WojciechM98/SynchGaze/README.md

# SynchGaze
A project that allows you to control camera movement by moving your head.

## Project assumptions
The project includes two boards SynchGaze Transmiter and SynchGaze Motor Control that communicate with each other via bluetooth.

## SynchGaze Transmiter
Transmiter board has IMU device to collect position, acceleration and rotation data. Every information is preprocessed and send in real time by ESP32 to Motor Control board.
This board should be neatly attached to the user's head.

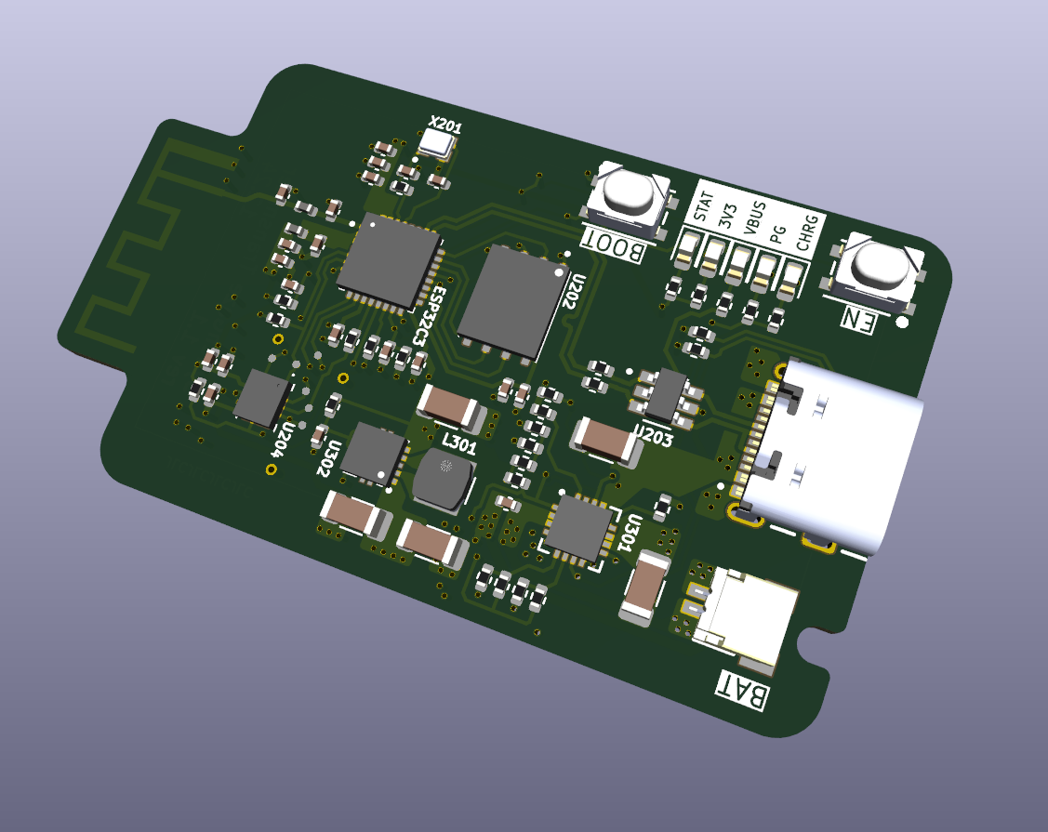
[picture p1: SynchGaze_Transmiter/SynchGaze_Transmiter_v1.1.png]
SynchGaze Transmiter board.


## SynchGaze Motor Control
Motor Control board recieve preprocessed data from Transmiter and converts it into BLDC motors movement. STM32 works in closed loop gathering data from external IMU device whith is attached in the same place as camera. When new information from Transmiter board is recieved the possition according to external IMU is corrected by sending information about revolutions and acceleration to specific motor controler.

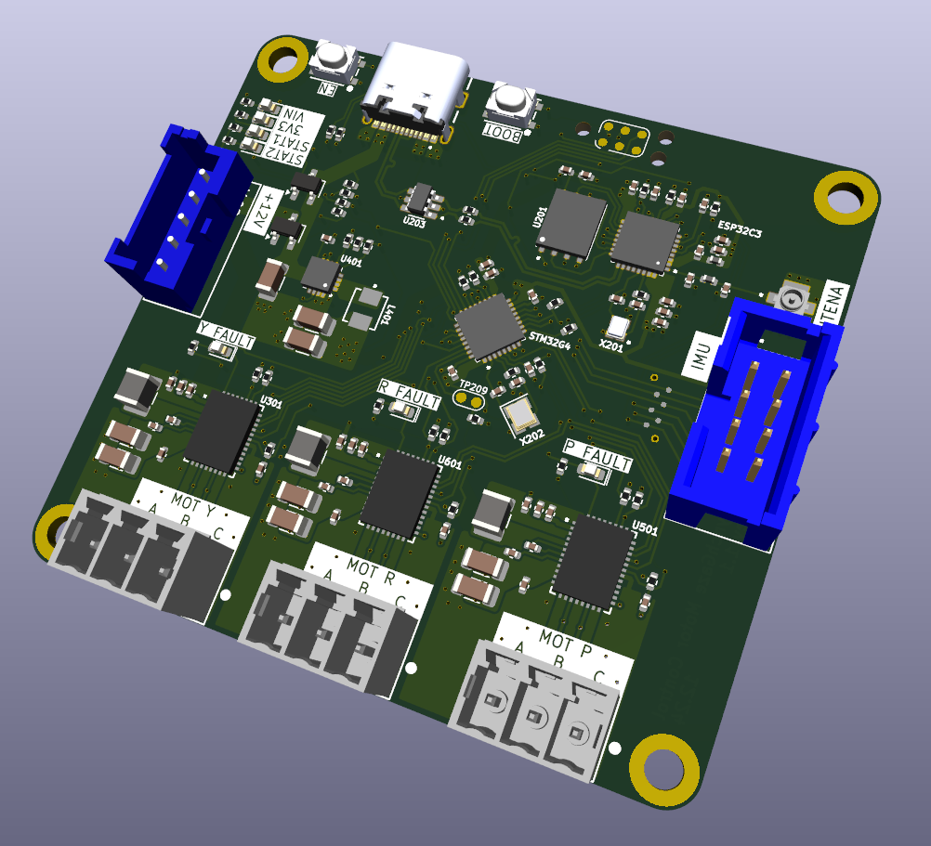
[picture p2: SynchGaze_Motor_Control/SynchGaze_Motor_Control_v1.1.png]
SynchGaze Motor Control board.
