WojciechM98/SynchGaze/SynchGaze_Motor_Control/SynchGaze_Motor_Control.step

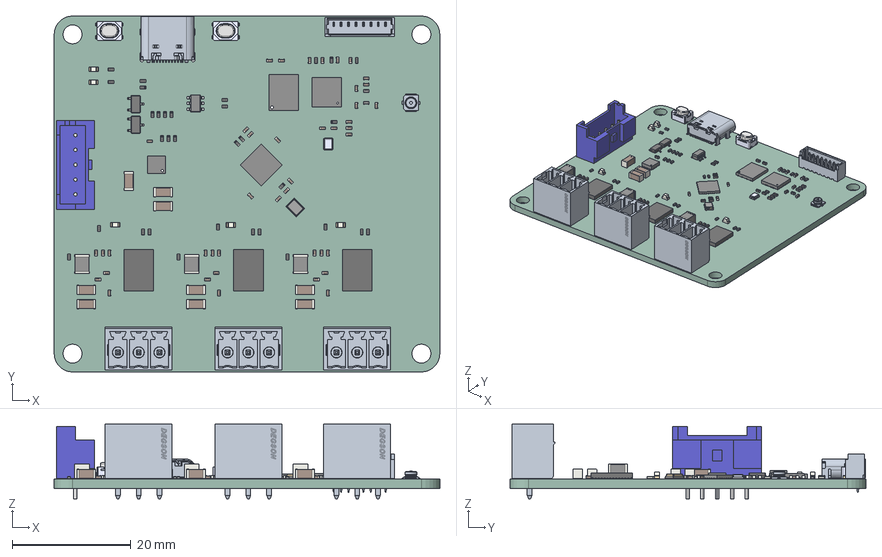
[picture p3: CAD file, 2025-01-06]
SynchGaze_Motor_Control/SynchGaze_Motor_Control.step
65.0 x 60.0 x 12.6 mm
XRCGB27M000F2P00R0
C_0402_1005Metric x 42
C_1206_3216Metric x 9
R_0402_1005Metric x 32
W25X40CLZPIG
L_1210_3225Metric x 3
STM32L051K8U6
TSOT_23 x 2
Admi07704AC6ofqq x 3
LED_0603_1608Metric x 5
Crystal_SMD_2520-4Pin_2.5x2.0mm
RGT16
QFN_ASM x 3
PTS810SJS250SMTR LFS x 2
L_0402_1005Metric x 2
USBLC6-2SC6Y
ESP32-C3FH4
B05B-XASK-1
C-CONMHF1-SMD-G-T
USB4105GFA
_autosave-SynchGaze_Motor_Control_PCB
