WojciechM98/SynchGaze/SynchGaze_Motor_Control/Schematic/SynchGaze_Motor_Control_Schematic_v1.1.pdf

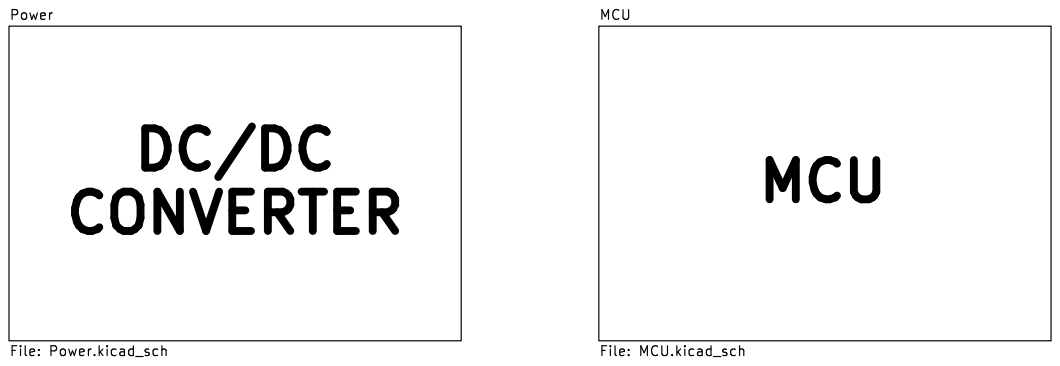
[picture p4: page 1]

File: MCU.kicad_sch DC/DC

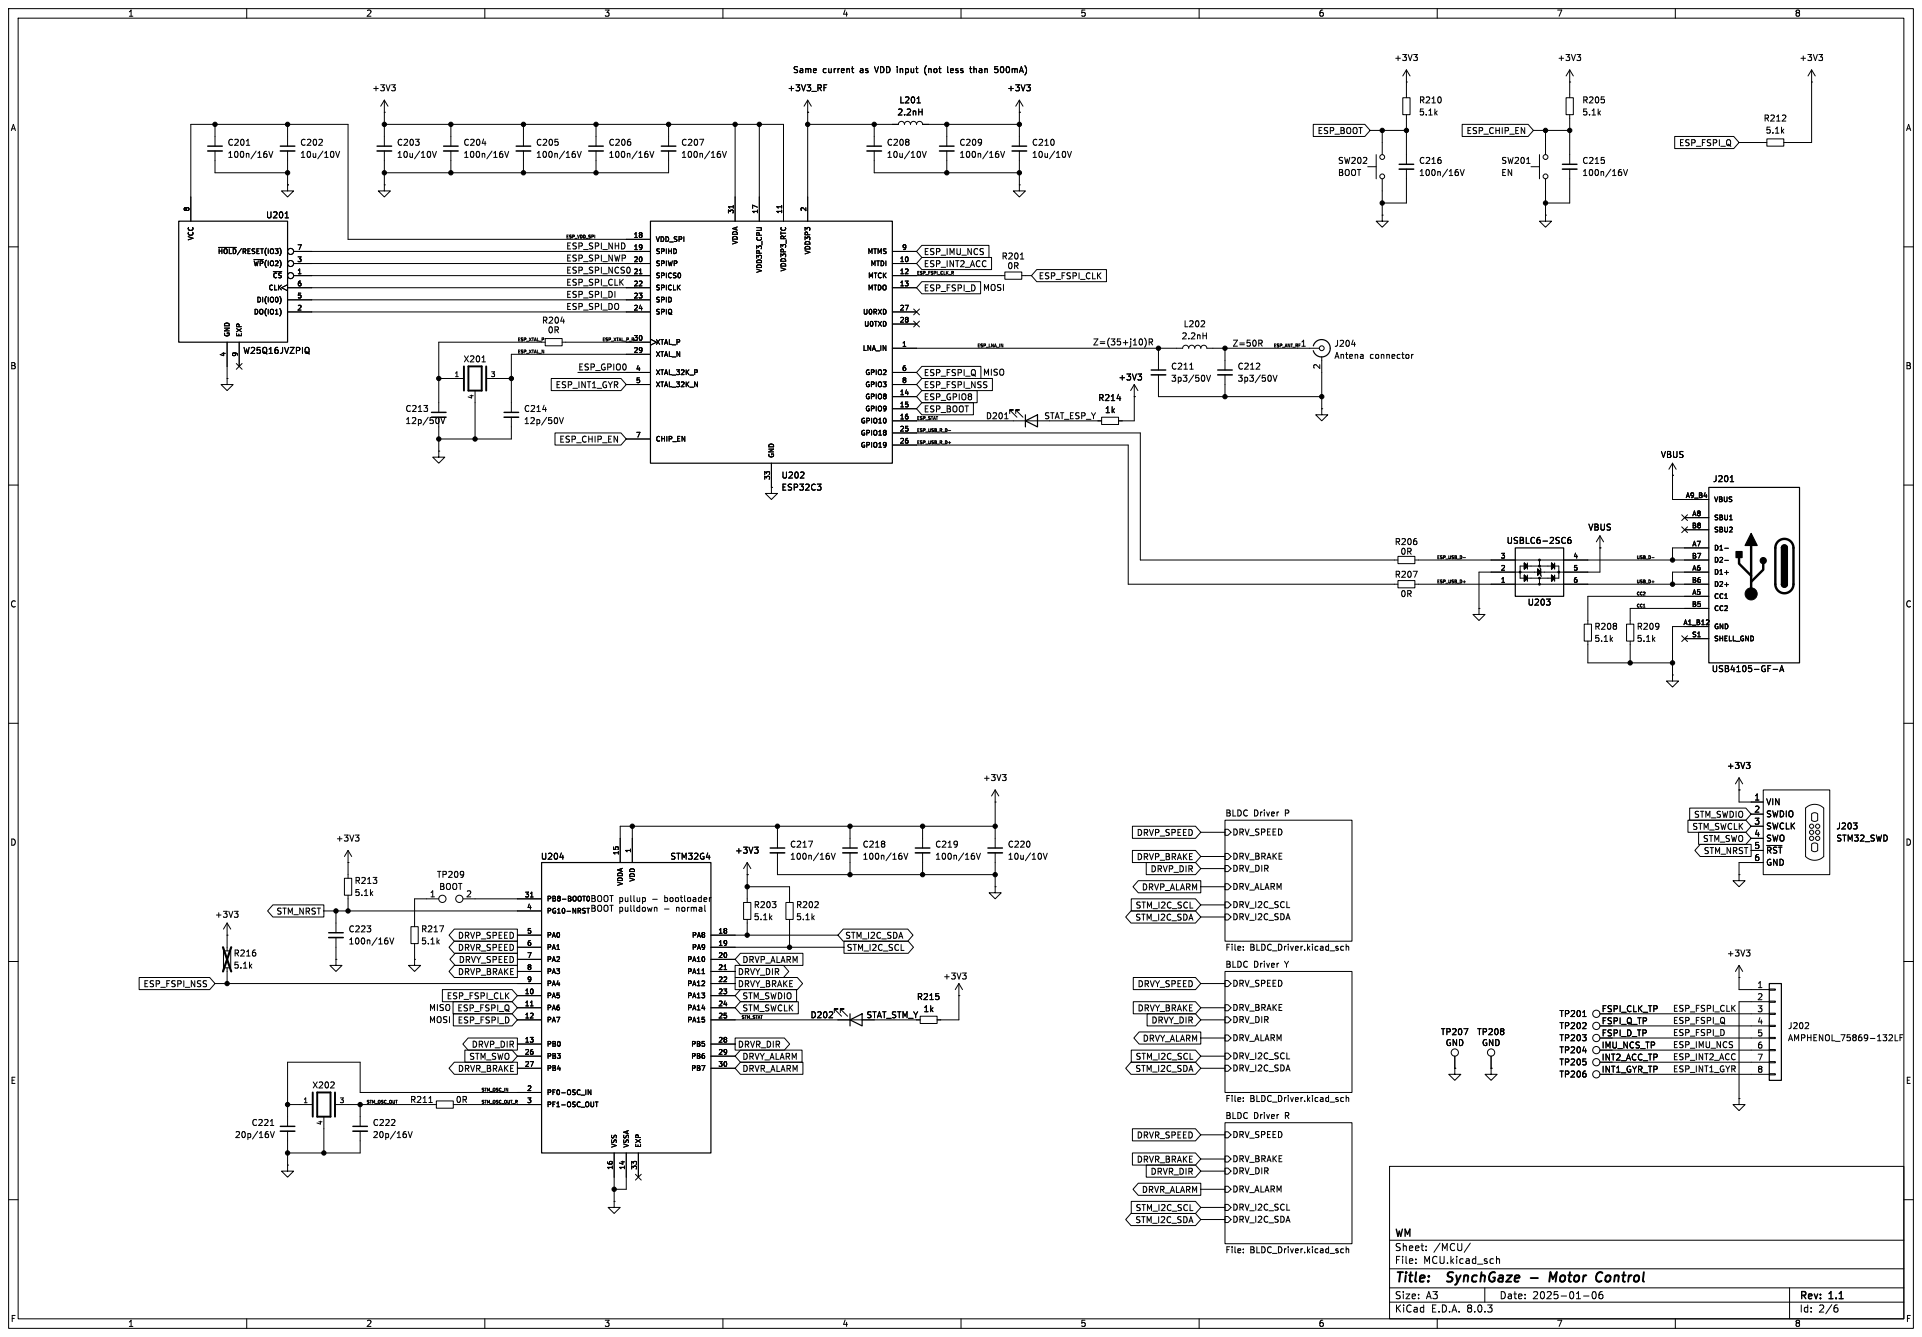
[picture p5: page 2]

Same current as VDD input (not less than 500mA) +3V3 C209

2 SPIWP 20 SPICS0 21 SPICLK 22 SPID 23 SPIQ 24 GPIO18 25 GPIO19 26 U0RXD 27 U0TXD 28 XTAL_N 29 XTAL_P 30 VDDA 31 GND 33 XTAL_32K_P 4 XTAL_32K_N 5 GPIO2 6 CHIP_EN 7 GPIO3 8 MTMS 9 U202 ESP32C3

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

9 ~{CS} 1 ~{WP}(IO2) 3 ~{HOLD}/RESET(IO3) 7 U201 W25Q16JVZPIQ

9 ~{CS} 1 ~{WP}(IO2) 3 ~{HOLD}/RESET(IO3) 7 U204 STM32G4 VDD

1 PA5 10 PA6 11 PA7 12 PB0 13 VSSA 14 VDDA 15 VSS 16 PA8 18 PA9 19 PF0-OSC_IN 2 PA10 20 PA11 21 PA12 22 PA13 23 PA14 24 PA15 25 PB3 26 PB4 27 PB5 28 PB6 29 PF1-OSC_OUT 3 PB7 30 PB8-BOOT0 31 EXP 33 PG10-NRST 4 PA0 5 PA1 6 PA2 7 PA3 8 PA4 9 U204 STM32G4 R207

1 PA5 10 PA6 11 PA7 12 PB0 13 VSSA 14 VDDA 15 VSS 16 PA8 18 PA9 19 PF0-OSC_IN 2 PA10 20 PA11 21 PA12 22 PA13 23 PA14 24 PA15 25 PB3 26 PB4 27 PB5 28 PB6 29 PF1-OSC_OUT 3 PB7 30 PB8-BOOT0 31 EXP 33 PG10-NRST 4 PA0 5 PA1 6 PA2 7 PA3 8 PA4 9 +3V3 TP204 IMU_NCS_TP

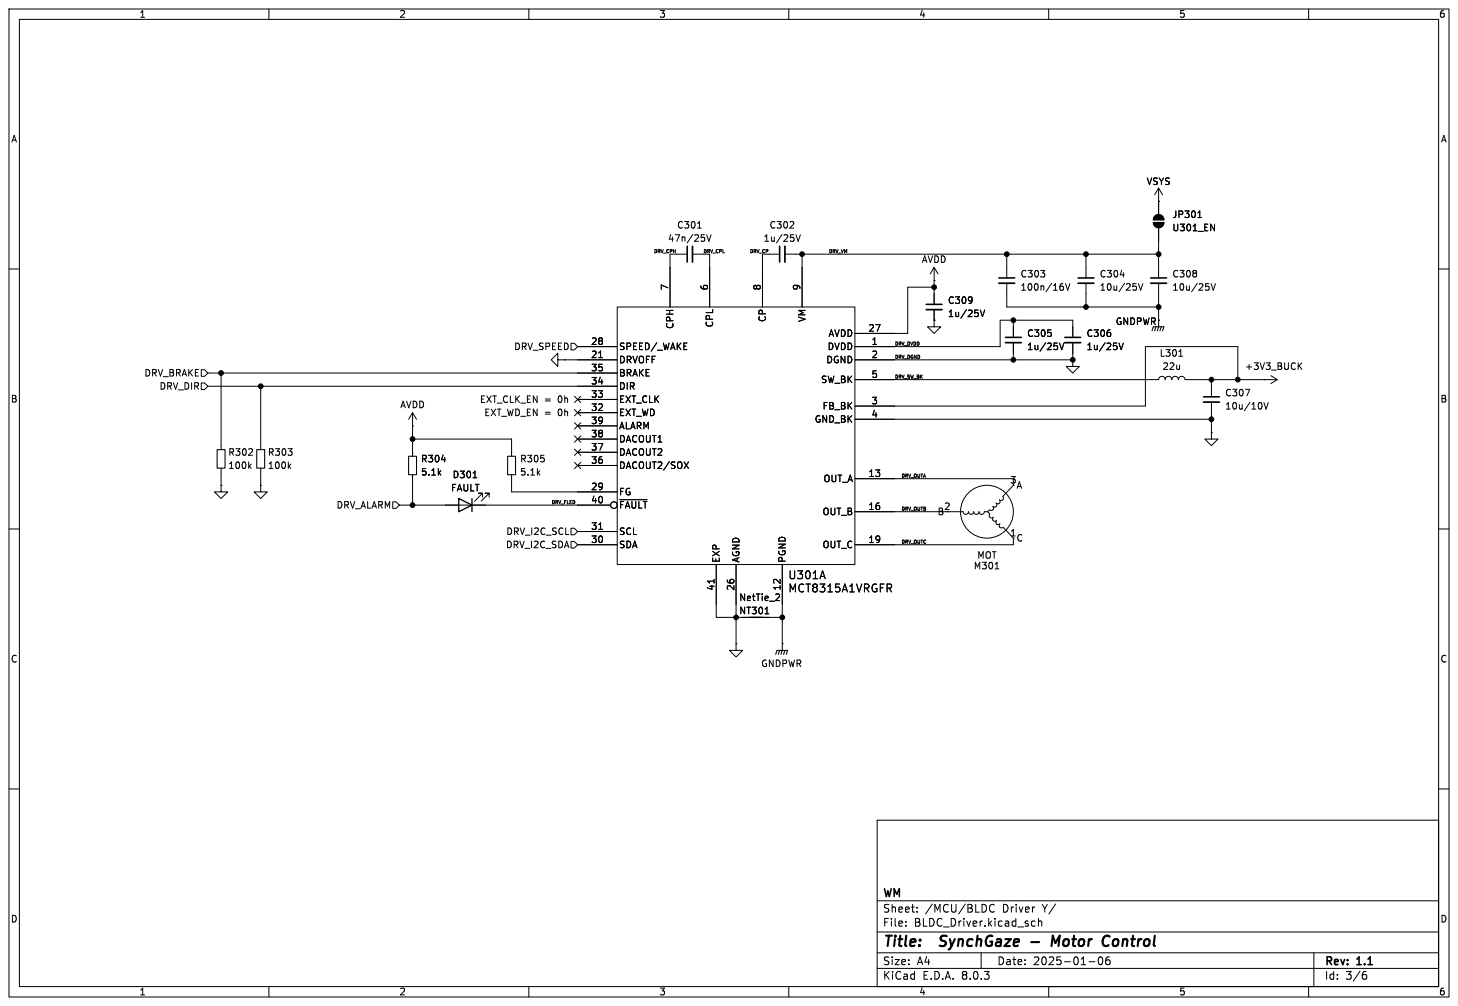
[picture p6: page 3]

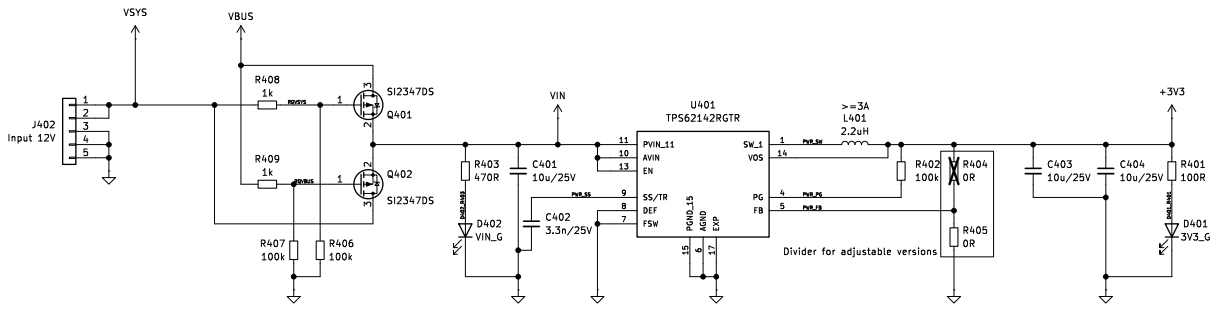
[picture p7: page 4]

6 FSW 7 DEF 8 SS/TR 9 U401 TPS62142RGTR

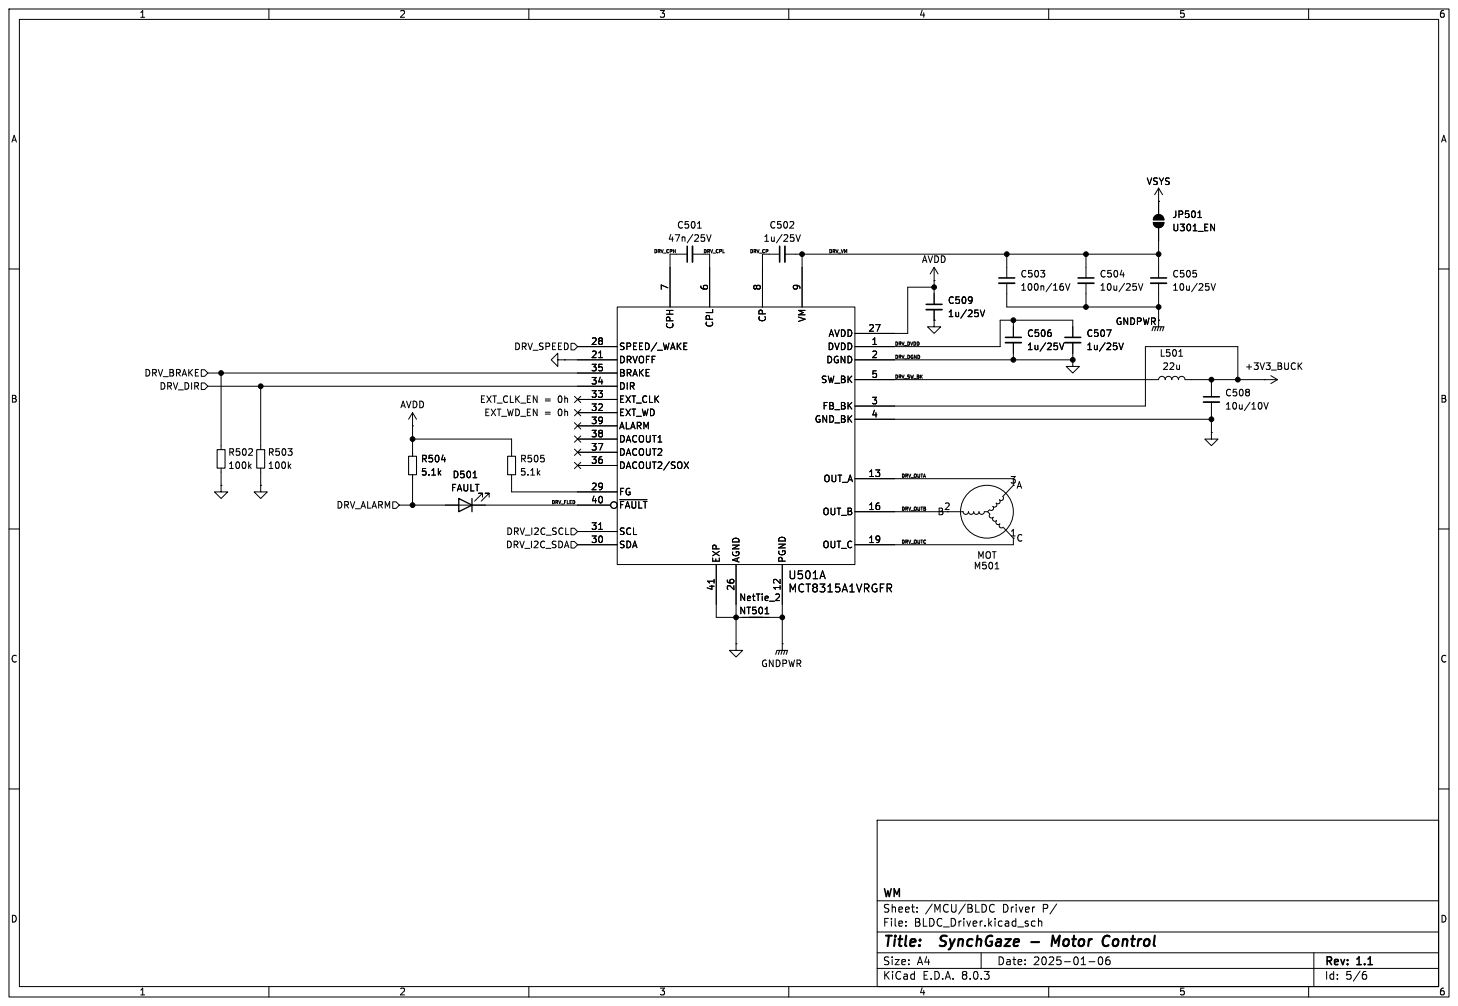
[picture p8: page 5]

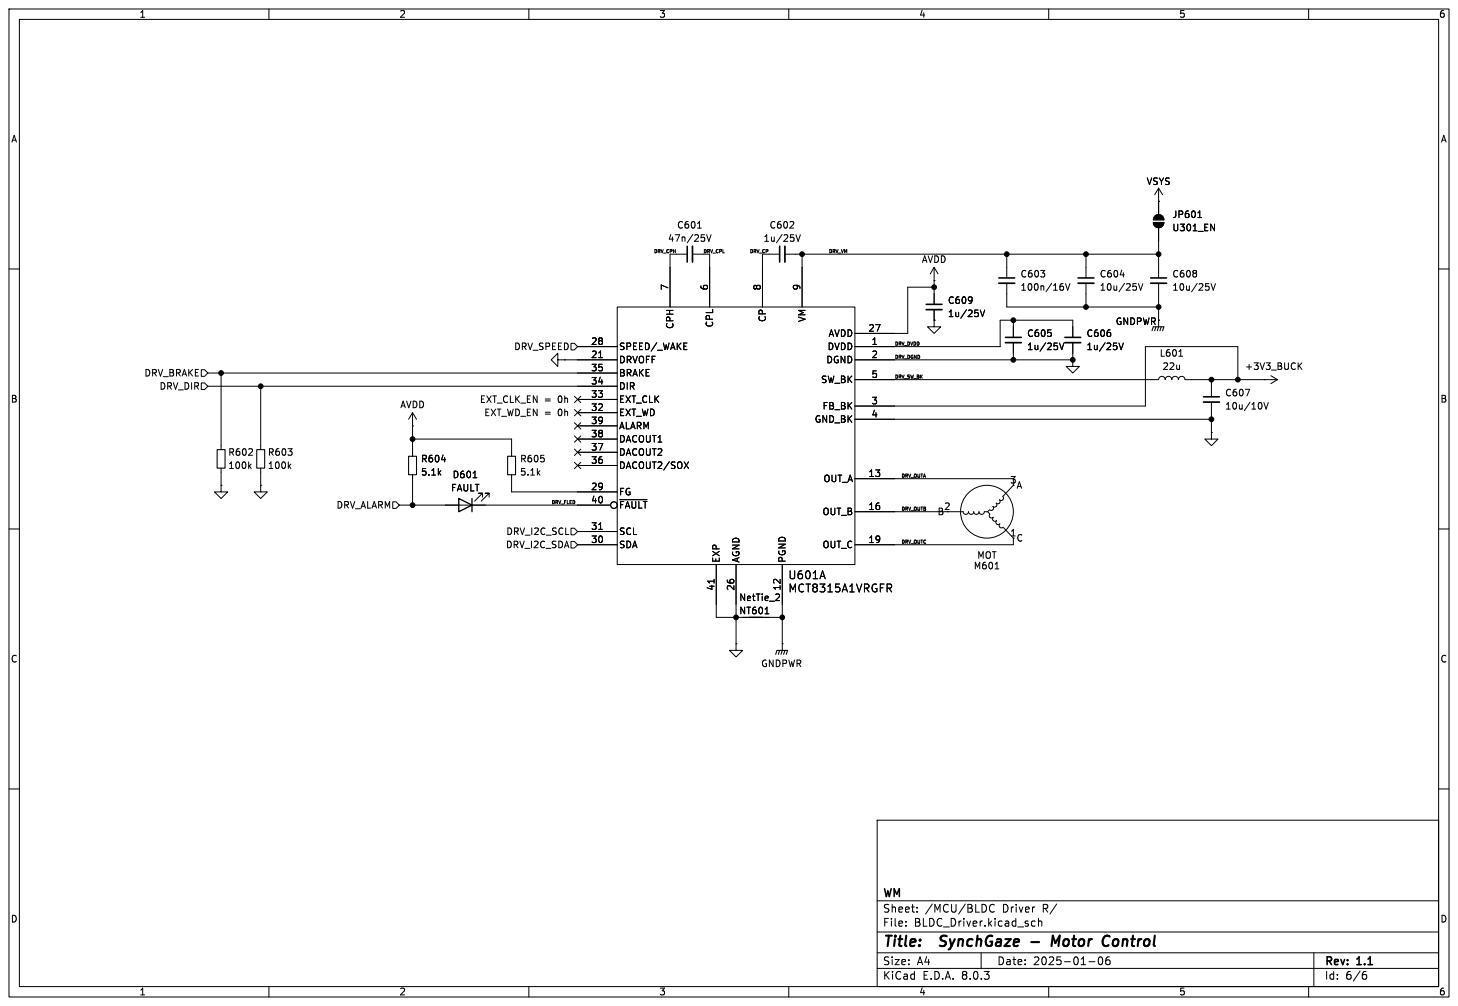
[picture p9: page 6]
