WojciechM98/SynchGaze/SynchGaze_Transmiter/Schematic/SynchGaze_Transmiter_Schematic_v1.1.pdf

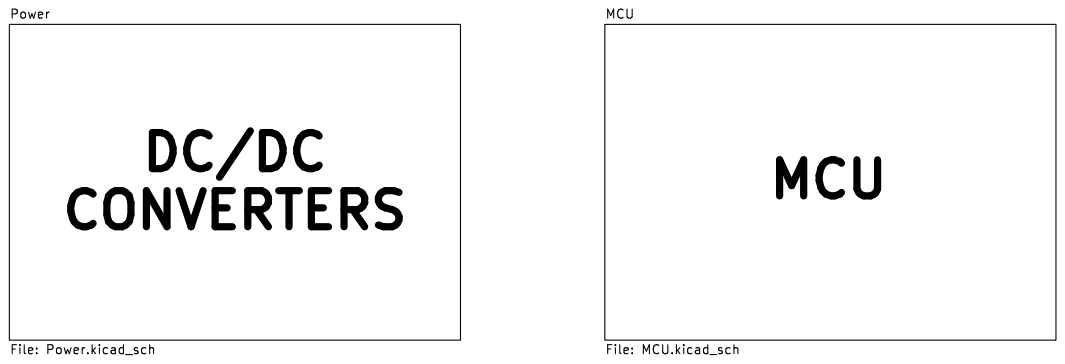
[picture p10: page 1]

Id: 1/3 Title: SynchGaze - Transmiter File: SynchGaze_Transmiter.kicad_sch Sheet: / WM

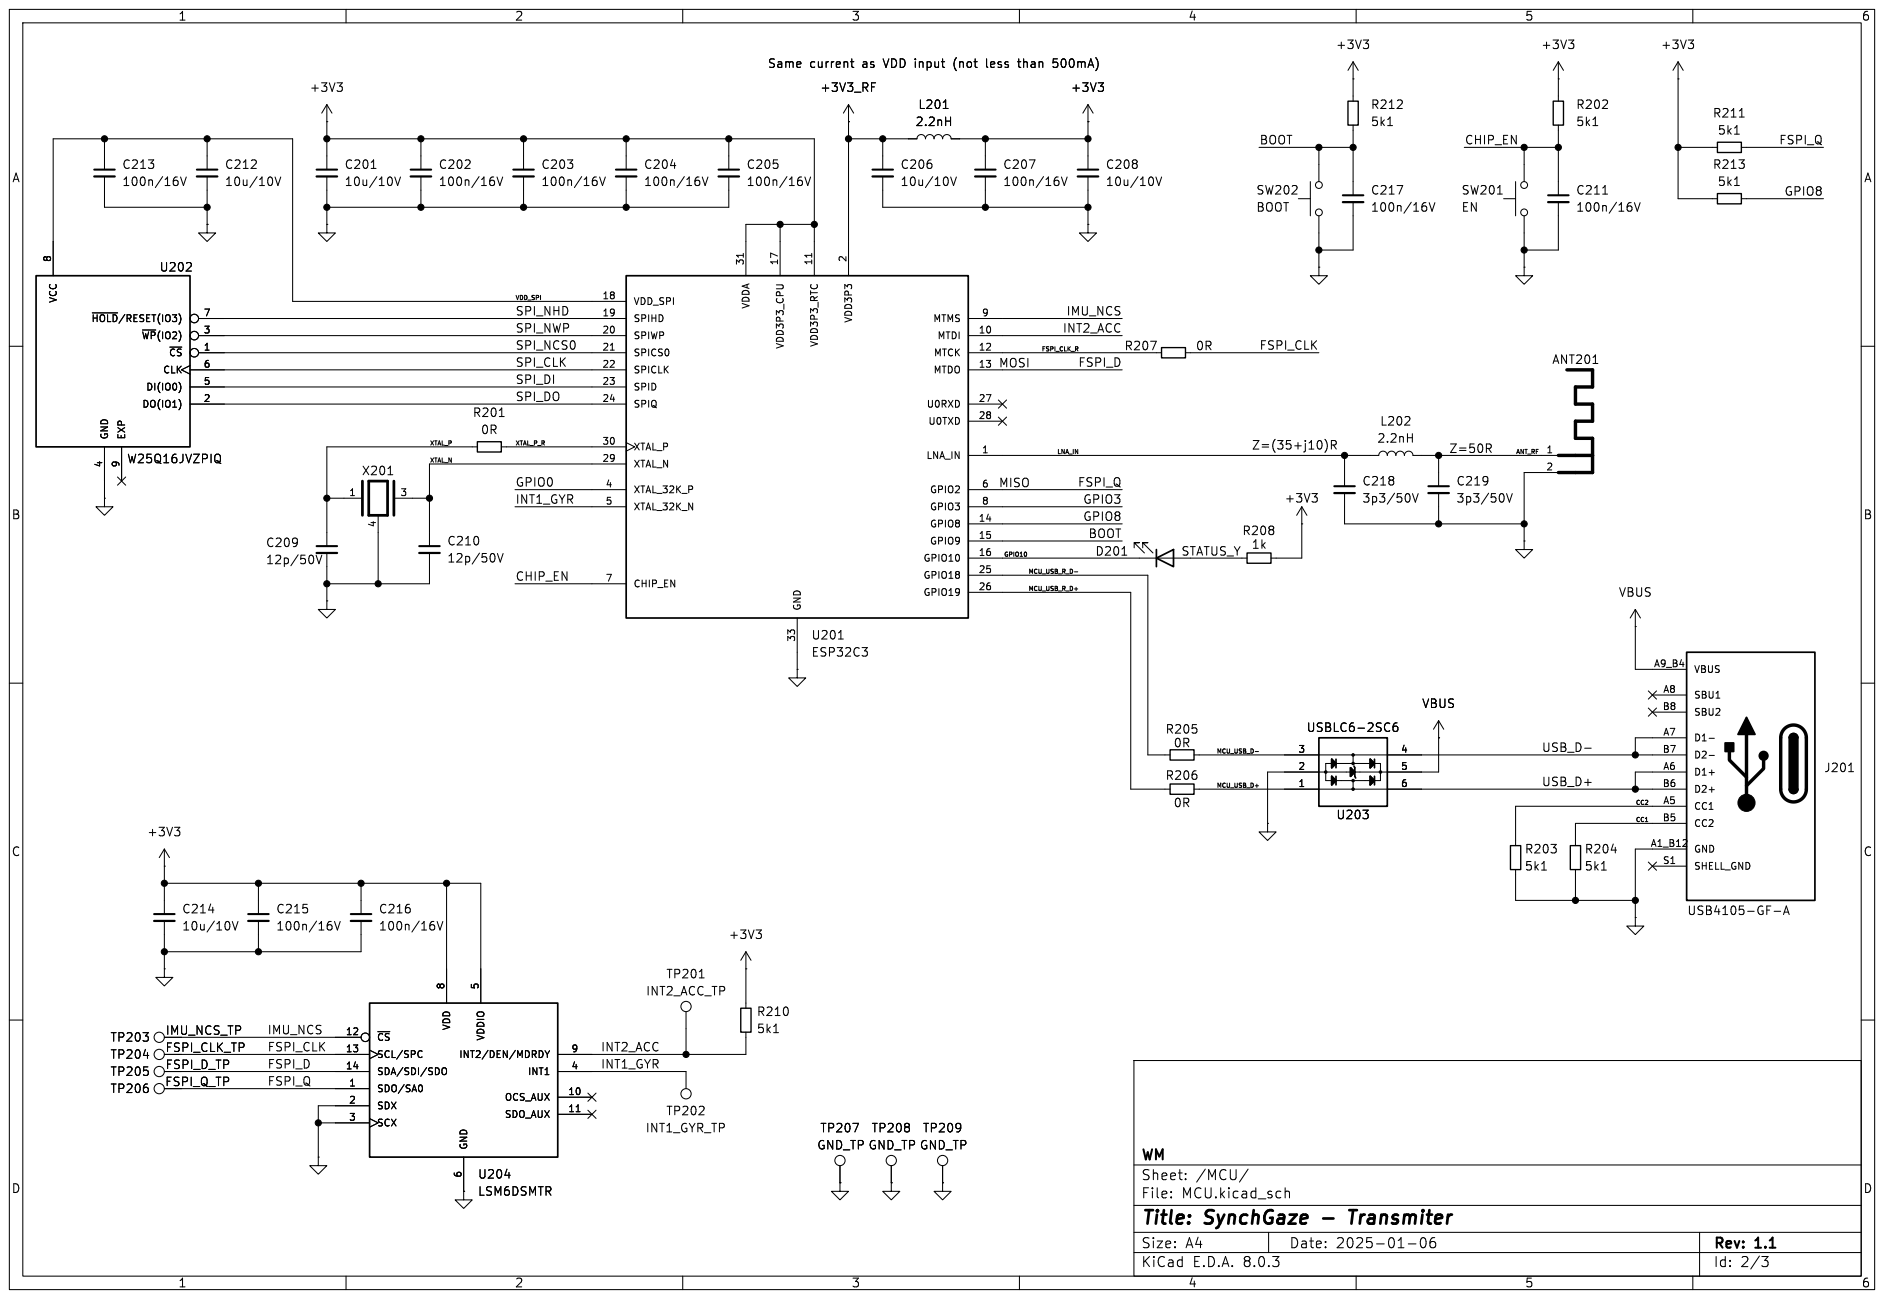
[picture p11: page 2]

Same current as VDD input (not less than 500mA) +3V3_RF

2 SPIWP 20 SPICS0 21 SPICLK 22 SPID 23 SPIQ 24 GPIO18 25 GPIO19 26 U0RXD 27 U0TXD 28 XTAL_N 29 XTAL_P 30 VDDA 31 GND 33 XTAL_32K_P 4 XTAL_32K_N 5 GPIO2 6 CHIP_EN 7 GPIO3 8 MTMS 9 U201 ESP32C3 C201
U202 W25Q16JVZPIQ

9 ~{CS} 1 ~{WP}(IO2) 3 ~{HOLD}/RESET(IO3) 7 U202 W25Q16JVZPIQ

9 ~{CS} 1 ~{WP}(IO2) 3 ~{HOLD}/RESET(IO3) 7 VBUS U203 USBLC6-2SC6

Id: 2/3 Title: SynchGaze - Transmiter File: MCU.kicad_sch Sheet: /MCU/ WM

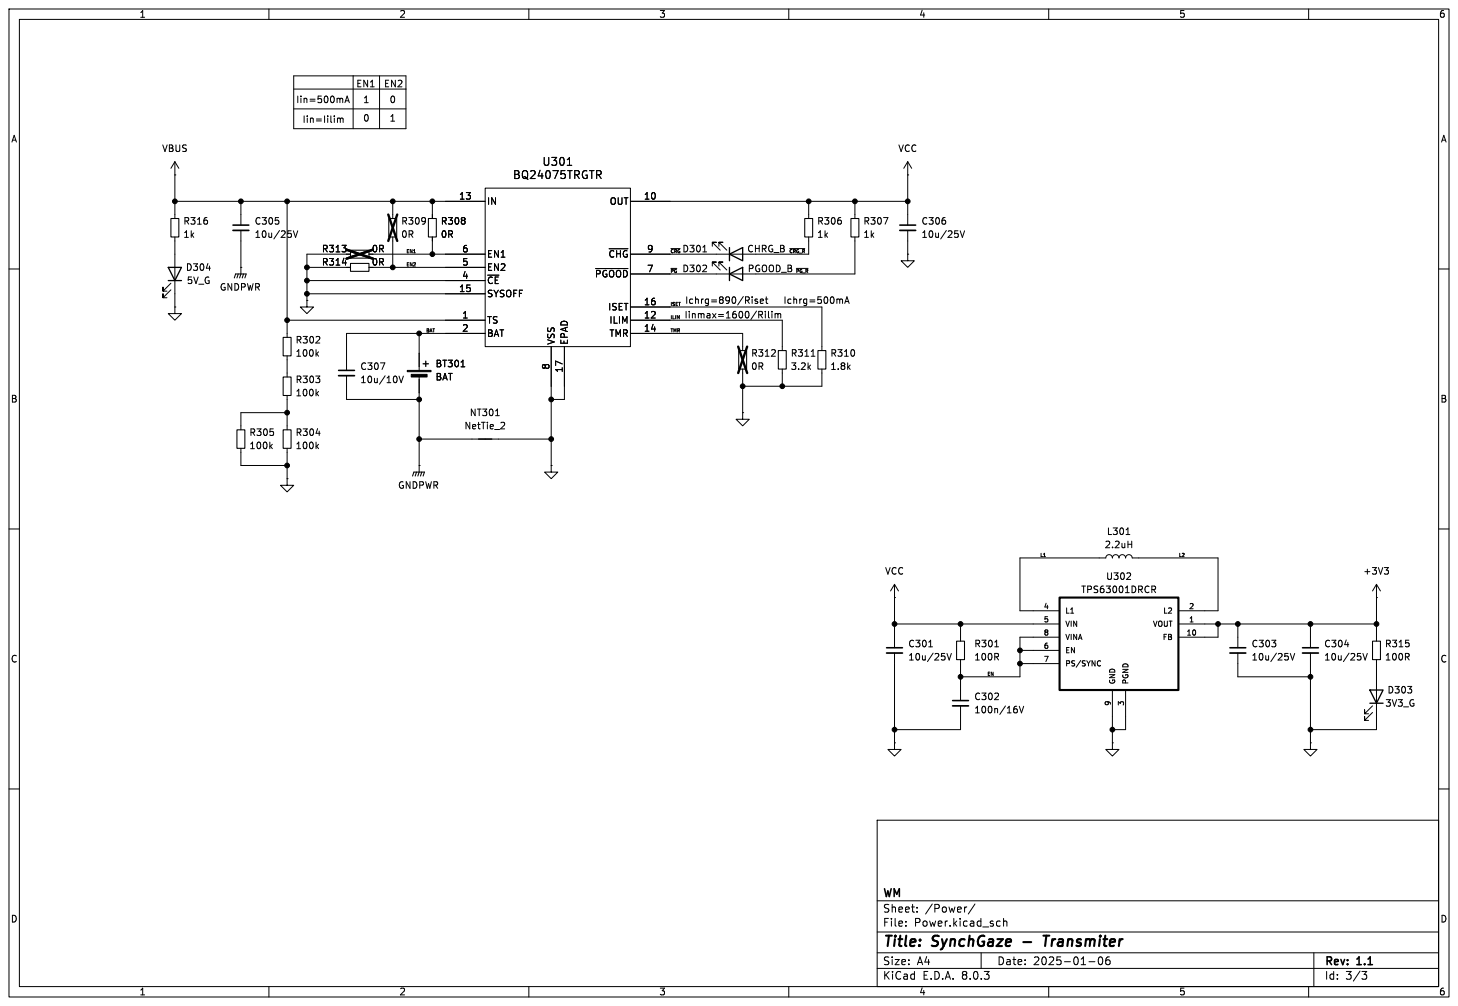
[picture p12: page 3]

Id: 3/3 Title: SynchGaze - Transmiter File: Power.kicad_sch Sheet: /Power/ WM
