WojciechM98/SynchGaze/SynchGaze_Motor_Control/SynchGaze_Motor_Control.kicad_pcb

## KiCad design SynchGaze_Motor_Control/SynchGaze_Motor_Control.kicad_pcb (2025-01-06)

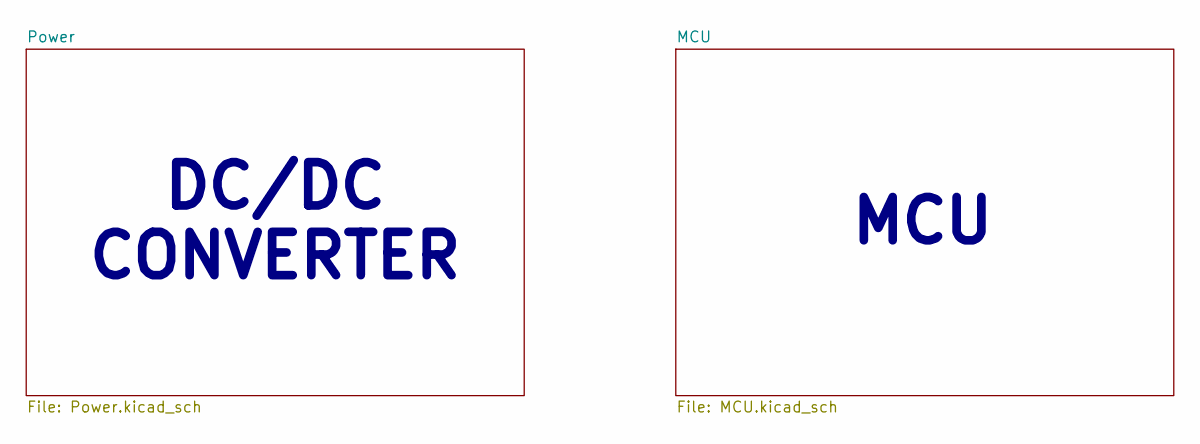
[picture p13: schematic SynchGaze_Motor_Control.kicad_sch, SynchGaze - Motor Control]

Notes on the sheet:
DC/DC CONVERTER
MCU

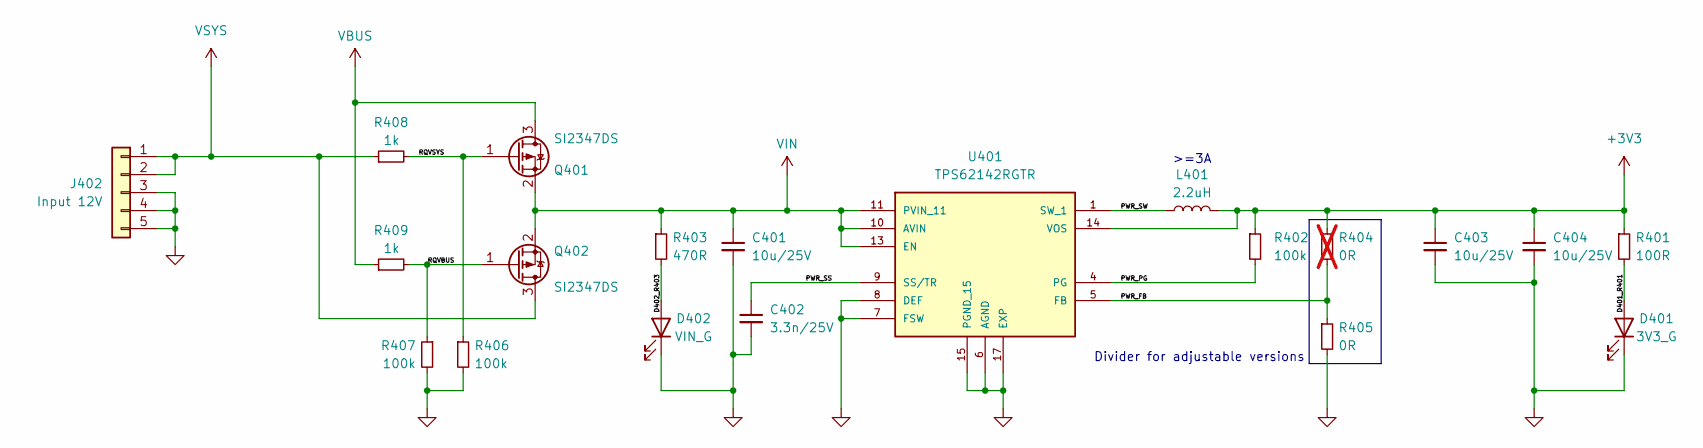
[picture p14: schematic Power.kicad_sch, SynchGaze - Motor Control]

Parts:
C401, C403, C404: 10u/25V; C_1206_3216Metric; Manufacturer Part Number CL31B106KAHNFNE
C402: 3.3n/25V; C_0402_1005Metric; Manufacturer Part Number 885012205047
D401: 3V3_G; LED_0603_1608Metric; Manufacturer Part Number 150060GS55040
D402: VIN_G; LED_0603_1608Metric; Manufacturer Part Number 150060GS55040
J402: Input 12V; CONN5_B05B-XASK-1-A_JST
L401: 2.2uH; IHLP1212BZEV2R2MA1; Manufacturer Part Number IHLP1212BZEV2R2MA1
Q401, Q402: SI2347DS; TSOT-23
R401: 100R; R_0402_1005Metric; Manufacturer Part Number RC0402JR-07100RP
R402, R406, R407: 100k; R_0402_1005Metric; Manufacturer Part Number WR04X104 JTL
R403: 470R; R_0402_1005Metric; Manufacturer Part Number RT0402FRE07470RL
R404: 0R; R_0402_1005Metric; Manufacturer Part Number RC0402JR-07100RP; not fitted
R405: 0R; R_0402_1005Metric; Manufacturer Part Number RC0402JR-070RP
R408, R409: 1k; R_0402_1005Metric; Manufacturer Part Number RT0402FRE07470RL
U401: TPS62142RGTR; QFN50P300X300X100-17N_TPS62142RGTR; PARTREV E

Connections:
+3V3: C403.1, C404.1, L401.2, R401.1, R402.1, R404.1, U401.14 (VOS); also elsewhere on the board
/Power/D401_R401: D401.2 (A), R401.2
/Power/D402_R403: D402.2 (A), R403.2
/Power/PWR_FB: R404.2, R405.1, U401.5 (FB)
/Power/PWR_PG: R402.2, U401.4 (PG)
/Power/PWR_SS: C402.1, U401.9 (SS/TR)
/Power/PWR_SW: L401.1, U401.1 (SW_1), U401.2 (SW_2), U401.3 (SW_3)
/Power/RQVBUS: Q402.1 (G), R407.1, R409.2
/Power/RQVSYS: Q401.1 (G), R406.1, R408.2
GND: C401.2, C402.2, C403.2, C404.2, D401.1 (K), D402.1 (K), J402.3, J402.4, J402.5, R405.2, R406.2, R407.2, U401.6 (AGND), U401.7 (FSW), U401.8 (DEF), U401.15 (PGND_15), U401.16 (PGND_16), U401.17 (EXP); also elsewhere on the board
VBUS: Q401.3 (D), R409.1; also elsewhere on the board
VIN: C401.1, Q401.2 (S), Q402.2 (S), R403.1, U401.10 (AVIN), U401.11 (PVIN_11), U401.12 (PVIN_12), U401.13 (EN)
VSYS: J402.1, J402.2, Q402.3 (D), R408.1; also elsewhere on the board

Notes on the sheet:
Divider for adjustable versions
>=3A

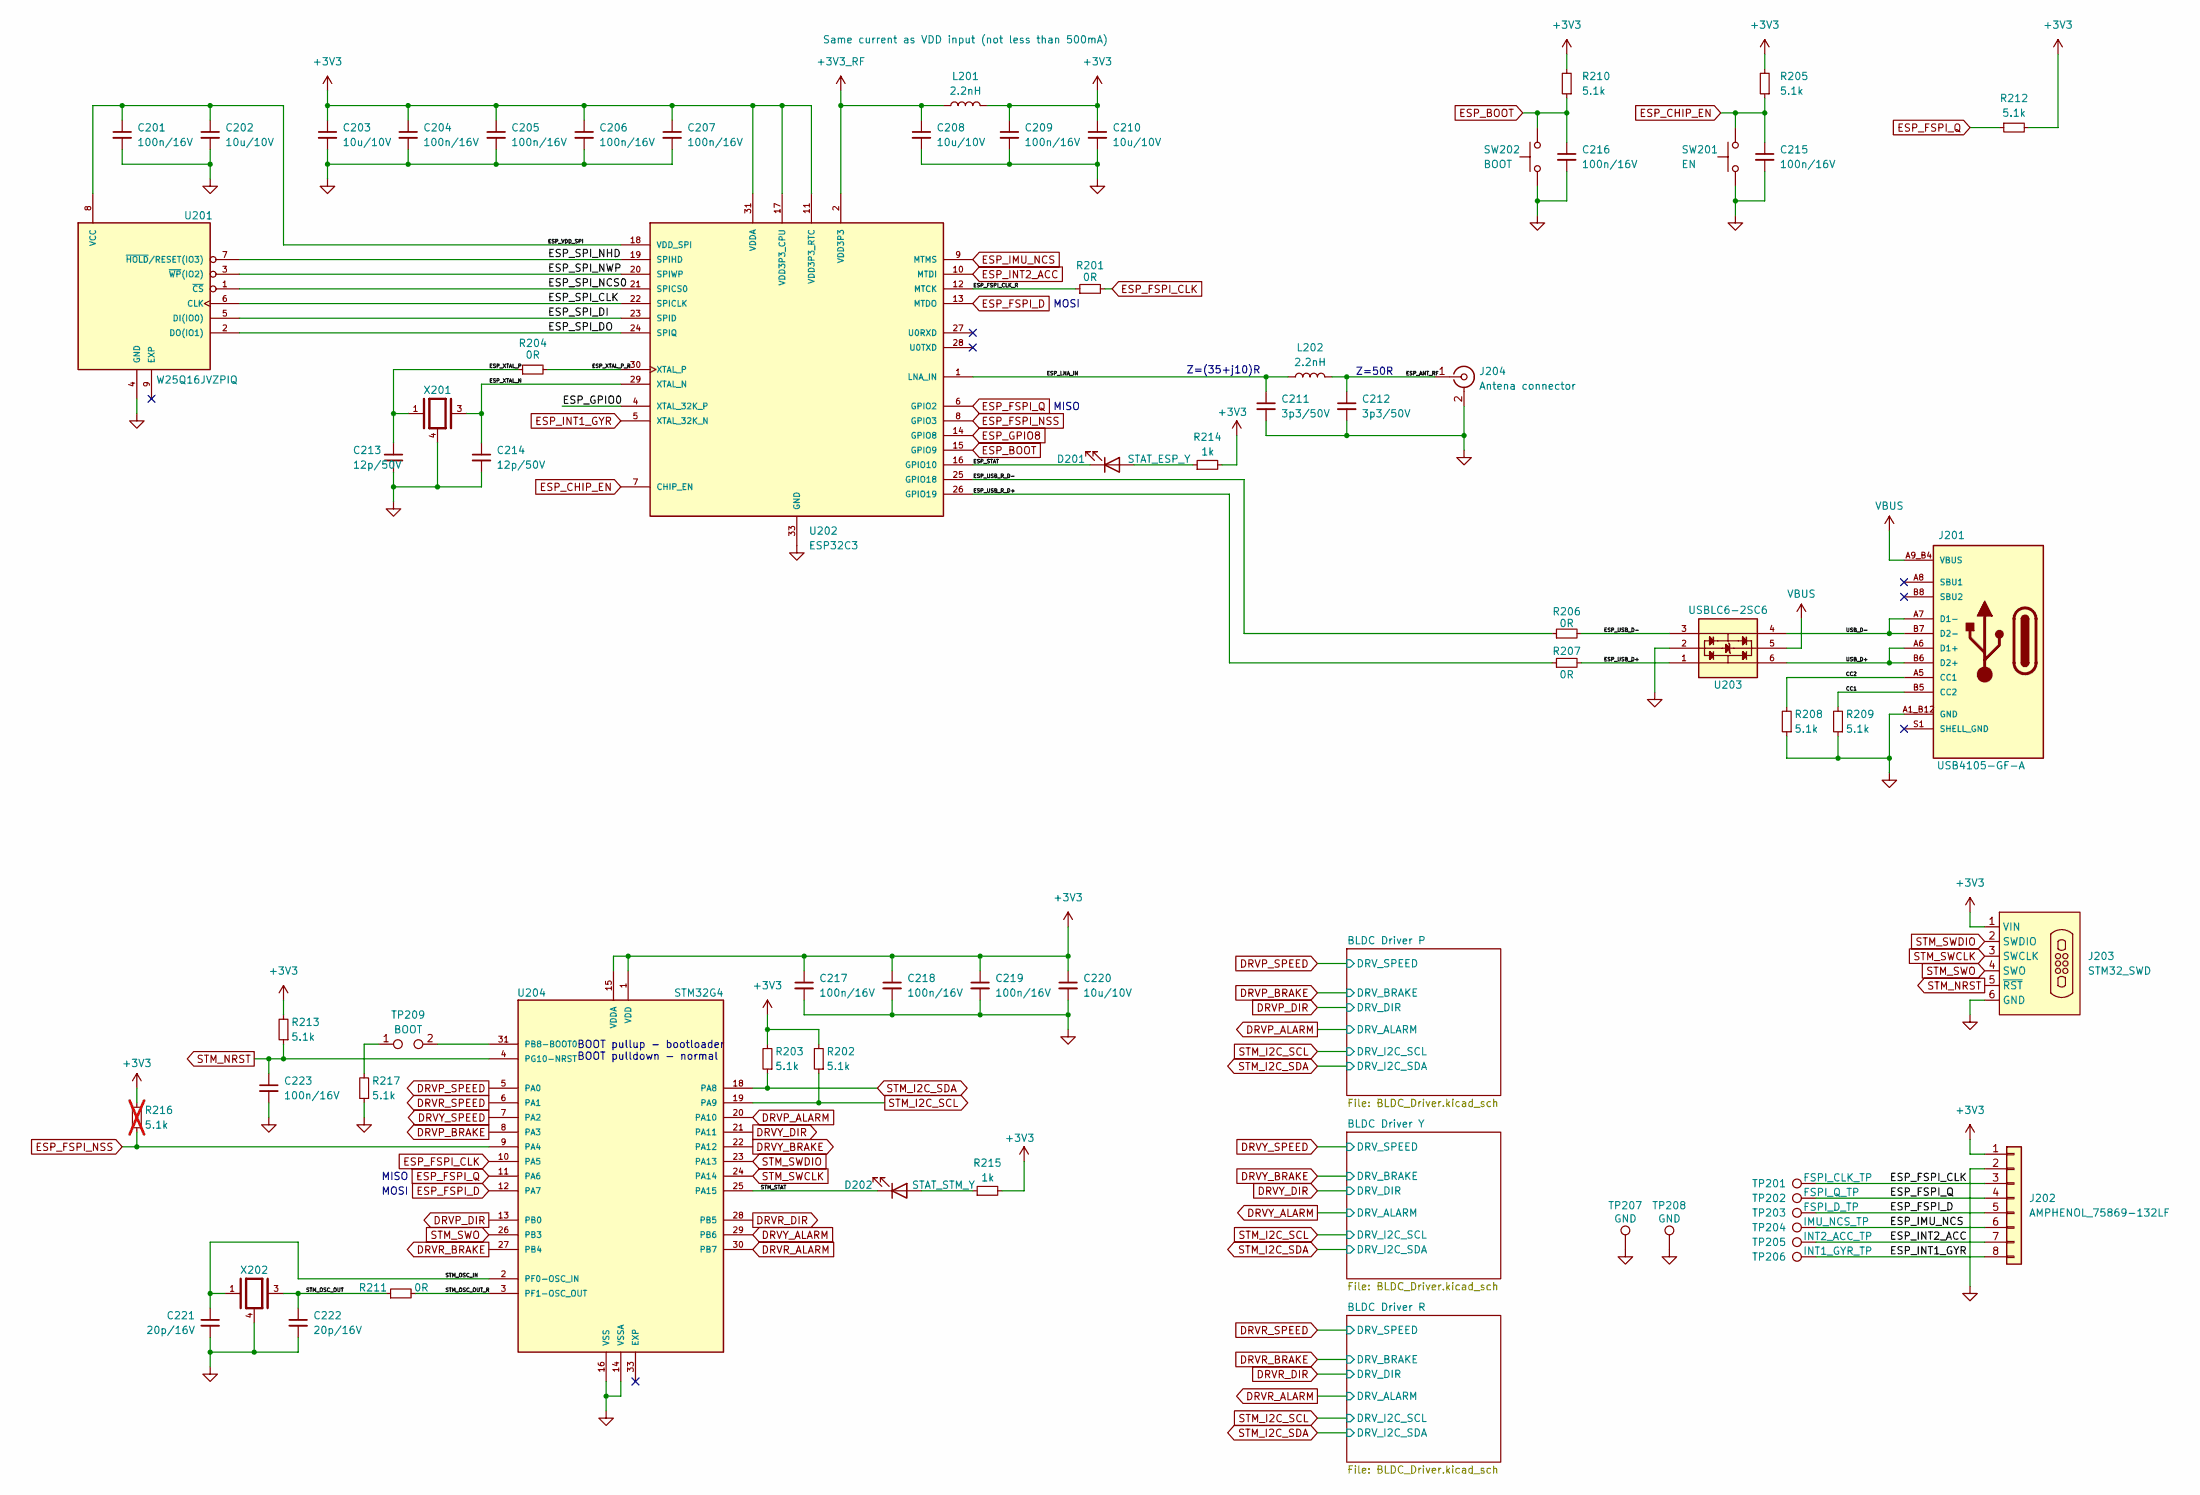
[picture p15: schematic MCU.kicad_sch, SynchGaze - Motor Control]

Parts:
C201, C204, C205, C206, C207, C209, C215, C216, C217, C218, C219, C223: 100n/16V; C_0402_1005Metric; Manufacturer Part Number CL05B104JO5NNNC
C202, C203, C208, C210, C220: 10u/10V; C_0402_1005Metric; Manufacturer Part Number GRM155R61A106ME11J
C211, C212: 3p3/50V; C_0402_1005Metric; Manufacturer Part Number 0402N3R3D500CT
C213, C214: 12p/50V; C_0402_1005Metric; Manufacturer Part Number GRM1555C1H120JA01D
C221, C222: 20p/16V; C_0402_1005Metric; Manufacturer Part Number 0402N200J160CT
D201: STAT_ESP_Y; LED_0603_1608Metric; Manufacturer Part Number 150060YS55040
D202: STAT_STM_Y; LED_0603_1608Metric; Manufacturer Part Number 150060YS55040
J201: USB4105-GF-A; GCT_USB4105-GF-A; PARTREV 3
J202: AMPHENOL_75869-132LF; Manufacturer Part Number 0530470810
J203: STM32_SWD; PogoConnector
J204: Antena connector; LINX_CONMHF1-SMD-G-T
L201, L202: 2.2nH; L_0402_1005Metric; Manufacturer Part Number LQG15HN2N2S02D
R201, R204, R206, R207, R211: 0R; R_0402_1005Metric; Manufacturer Part Number RC0402JR-070RP
R202, R203, R205, R208, R209, R210, R212, R213, R217: 5.1k; R_0402_1005Metric; Manufacturer Part Number RT0402FRE075K1L
R214, R215: 1k; R_0402_1005Metric; Manufacturer Part Number RT0402FRE07470RL
R216: 5.1k; R_0402_1005Metric; Manufacturer Part Number RT0402FRE075K1L; not fitted
SW201: EN; SW4_PTS815 SJM 250 SMTR LFS_CNK; Manufacturer Part Number RKB2SJM250SMTR LFS
SW202: BOOT; SW4_PTS815 SJM 250 SMTR LFS_CNK; Manufacturer Part Number RKB2SJM250SMTR LFS
TP201: FSPI_CLK_TP; test_point_SMD_0.5mm
TP202: FSPI_Q_TP; test_point_SMD_0.5mm
TP203: FSPI_D_TP; test_point_SMD_0.5mm
TP204: IMU_NCS_TP; test_point_SMD_0.5mm
TP205: INT2_ACC_TP; test_point_SMD_0.5mm
TP206: INT1_GYR_TP; test_point_SMD_0.5mm
TP207, TP208: GND; test_point_THT 0.7mm
TP209: BOOT; test_point_SMD_two_pad_1mm
U201: W25Q16JVZPIQ; SON127P500X600X80-9N; Manufacturer Part Number W25Q16JVZPIQ
U202: ESP32C3; QFN32_5X5MM_ESP32C3; Manufacturer Part Number ESP32-C3
U203: USBLC6-2SC6; SOT95P280X145-6N; Manufacturer Part Number USBLC6-2SC6
U204: STM32G4; QFN50P500X500X60-33N_STM32G431KBU3; PARTREV 4
X201: XRCGB40M000F4M02R0; OSC_XRCGB40M000F4M02R0; PARTREV N/A
X202: 830108208209; Crystal_SMD_2520-4Pin_2.5x2.0mm; Manufacturer Part Number 830108208209

Connections:
+3V3: C203.1, C204.1, C205.1, C206.1, C207.1, C209.1, C210.1, C217.1, C218.1, C219.1, C220.1, J202.1, J203.1 (VIN), L201.2, R202.2, R203.2, R205.2, R210.2, R212.2, R213.2, R214.2, R215.2, R216.2, U202.11 (VDD3P3_RTC), U202.17 (VDD3P3_CPU), U202.31 (VDDA), U202.32 (VDDA), U204.1 (VDD), U204.15 (VDDA), U204.17 (VDD); also elsewhere on the board
+3V3_RF: C208.1, L201.1, U202.2 (VDD3P3), U202.3 (VDD3P3)
/MCU/CC1: J201.B5 (CC2), R209.2
/MCU/CC2: J201.A5 (CC1), R208.2
/MCU/ESP_ANT_RF: C212.1, J204.1 (In), L202.2
/MCU/ESP_FSPI_CLK_R: R201.1, U202.12 (MTCK)
/MCU/ESP_GPIO0: U202.4 (XTAL_32K_P)
/MCU/ESP_LNA_IN: C211.1, L202.1, U202.1 (LNA_IN)
/MCU/ESP_SPI_CLK: U201.6 (CLK), U202.22 (SPICLK)
/MCU/ESP_SPI_DI: U201.5 (DI(IO0)), U202.23 (SPID)
/MCU/ESP_SPI_DO: U201.2 (DO(IO1)), U202.24 (SPIQ)
/MCU/ESP_SPI_NCS0: U201.1 (~CS), U202.21 (SPICS0)
/MCU/ESP_SPI_NHD: U201.7 (~HOLD/RESET(IO3)), U202.19 (SPIHD)
/MCU/ESP_SPI_NWP: U201.3 (~WP(IO2)), U202.20 (SPIWP)
/MCU/ESP_STAT: D201.1 (K), U202.16 (GPIO10)
/MCU/ESP_USB_D+: R207.2, U203.1
/MCU/ESP_USB_D-: R206.2, U203.3
/MCU/ESP_USB_R_D+: R207.1, U202.26 (GPIO19)
/MCU/ESP_USB_R_D-: R206.1, U202.25 (GPIO18)
/MCU/ESP_VDD_SPI: C201.1, C202.1, U201.8 (VCC), U202.18 (VDD_SPI)
/MCU/ESP_XTAL_N: C214.1, U202.29 (XTAL_N), X201.3
/MCU/ESP_XTAL_P: C213.1, R204.1, X201.1
/MCU/ESP_XTAL_P_R: R204.2, U202.30 (XTAL_P)
/MCU/STM_OSC_IN: C221.1, U204.2 (PF0-OSC_IN), X202.1
/MCU/STM_OSC_OUT: C222.1, R211.1, X202.3
/MCU/STM_OSC_OUT_R: R211.2, U204.3 (PF1-OSC_OUT)
/MCU/STM_STAT: D202.1 (K), U204.25 (PA15)
/MCU/USB_D+: J201.A6 (D1+), J201.B6 (D2+), U203.6
/MCU/USB_D-: J201.A7 (D1-), J201.B7 (D2-), U203.4
DRVP_ALARM: U204.20 (PA10); also elsewhere on the board
DRVP_BRAKE: U204.8 (PA3); also elsewhere on the board
DRVP_DIR: U204.13 (PB0); also elsewhere on the board
DRVP_SPEED: U204.5 (PA0); also elsewhere on the board
DRVR_ALARM: U204.30 (PB7); also elsewhere on the board
DRVR_BRAKE: U204.27 (PB4); also elsewhere on the board
DRVR_DIR: U204.28 (PB5); also elsewhere on the board
DRVR_SPEED: U204.6 (PA1); also elsewhere on the board
DRVY_ALARM: U204.29 (PB6); also elsewhere on the board
DRVY_BRAKE: U204.22 (PA12); also elsewhere on the board
DRVY_DIR: U204.21 (PA11); also elsewhere on the board
DRVY_SPEED: U204.7 (PA2); also elsewhere on the board
ESP_BOOT: C216.1, R210.1, SW202.2, U202.15 (GPIO9)
ESP_CHIP_EN: C215.1, R205.1, SW201.2, U202.7 (CHIP_EN)
ESP_FSPI_CLK: J202.3, R201.2, TP201.1, U204.10 (PA5)
ESP_FSPI_D: J202.5, TP203.1, U202.13 (MTDO), U204.12 (PA7)
ESP_FSPI_NSS: R216.1, U202.8 (GPIO3), U204.9 (PA4)
ESP_FSPI_Q: J202.4, R212.1, TP202.1, U202.6 (GPIO2), U204.11 (PA6)
ESP_GPIO8: U202.14 (GPIO8)
ESP_IMU_NCS: J202.6, TP204.1, U202.9 (MTMS)
ESP_INT1_GYR: J202.8, TP206.1, U202.5 (XTAL_32K_N)
ESP_INT2_ACC: J202.7, TP205.1, U202.10 (MTDI)
GND: C201.2, C202.2, C203.2, C204.2, C205.2, C206.2, C207.2, C208.2, C209.2, C210.2, C211.2, C212.2, C213.2, C214.2, C215.2, C216.2, C217.2, C218.2, C219.2, C220.2, C221.2, C222.2, C223.2, J201.A1_B12 (GND), J201.A12_B1 (GND), J202.2, J203.6 (GND), J204.2 (Ext), R208.1, R209.1, R217.1, SW201.1, SW202.1, TP207.1, TP208.1, U201.4 (GND), U202.33 (GND), U203.2, U204.14 (VSSA), U204.16 (VSS), U204.32 (VSS), X201.2, X201.4, X202.2, X202.4; also elsewhere on the board
unnamed: D201.2 (A), R214.1
unnamed: D202.2 (A), R215.1
unnamed: R217.2, TP209.1
unnamed: TP209.2, U204.31 (PB8-BOOT0)
STM_I2C_SCL: R202.1, U204.19 (PA9); also elsewhere on the board
STM_I2C_SDA: R203.1, U204.18 (PA8); also elsewhere on the board
STM_NRST: C223.1, J203.5 (~RST), R213.1, U204.4 (PG10-NRST)
STM_SWCLK: J203.3 (SWCLK), U204.24 (PA14)
STM_SWDIO: J203.2 (SWDIO), U204.23 (PA13)
STM_SWO: J203.4 (SWO), U204.26 (PB3)
VBUS: J201.A4_B9 (VBUS), J201.A9_B4 (VBUS), U203.5; also elsewhere on the board

Notes on the sheet:
MOSI
Z=(35+j10)R
BOOT pullup - bootloader BOOT pulldown - normal
MISO
Z=50R

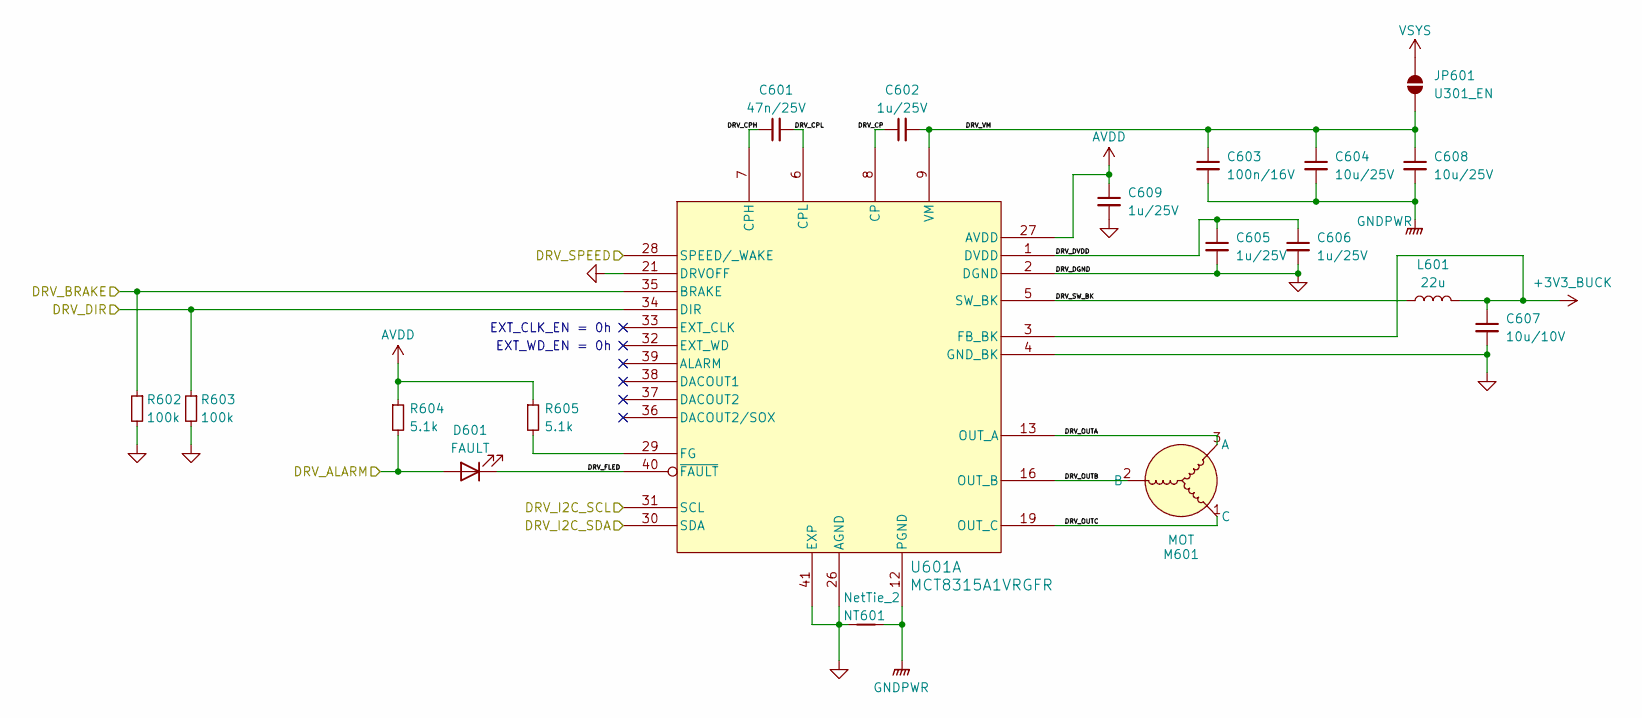
[picture p16: schematic BLDC_Driver.kicad_sch, SynchGaze - Motor Control]

Parts:
C601: 47n/25V; C_0402_1005Metric; Manufacturer Part Number GRT155R71E473KE01D
C602, C605, C606, C609: 1u/25V; C_0402_1005Metric; Manufacturer Part Number GRM155R61E105KA12J
C603: 100n/16V; C_0402_1005Metric; Manufacturer Part Number CL05B104JO5NNNC
C604, C608: 10u/25V; C_1206_3216Metric; Manufacturer Part Number CL31B106KAHNFNE
C607: 10u/10V; C_0402_1005Metric; Manufacturer Part Number GRM155R61A106ME11J
D601: FAULT; LED_0603_1608Metric; Manufacturer Part Number SML-D12U1WT86
JP601: U301_EN; SolderJumper-2_P1.3mm_Open_RoundedPad1.0x1.5mm
L601: 22u; L_1210_3225Metric; Manufacturer Part Number CBC3225T220MR
M601: MOT; 15EDGVC-3-5-03P
NT601: NetTie_2; NetTie_2_0.4mm
R602, R603: 100k; R_0402_1005Metric; Manufacturer Part Number WR04X104 JTL
R604, R605: 5.1k; R_0402_1005Metric; Manufacturer Part Number RT0402FRE075K1L
U601: MCT8315A1VRGFR; VQFN40_RGF_TEX_MCT8315A1VRGFR; Manufacturer Part Number MCT8315A1VRGFR

Connections:
+3V3_BUCK: C607.1, L601.2, U601.3 (FB_BK); also elsewhere on the board
/MCU/BLDC Driver R/DRV_CP: C602.1, U601.8 (CP)
/MCU/BLDC Driver R/DRV_CPH: C601.1, U601.7 (CPH)
/MCU/BLDC Driver R/DRV_CPL: C601.2, U601.6 (CPL)
/MCU/BLDC Driver R/DRV_DVDD: C605.1, C606.1, U601.1 (DVDD)
/MCU/BLDC Driver R/DRV_FLED: D601.1 (K), U601.40 (~FAULT)
/MCU/BLDC Driver R/DRV_OUTA: M601.3 (A), U601.13 (OUT_A), U601.14 (OUT_A)
/MCU/BLDC Driver R/DRV_OUTB: M601.2 (B), U601.16 (OUT_B), U601.17 (OUT_B)
/MCU/BLDC Driver R/DRV_OUTC: M601.1 (C), U601.19 (OUT_C), U601.20 (OUT_C)
/MCU/BLDC Driver R/DRV_SW_BK: L601.1, U601.5 (SW_BK)
AVDD: C609.1, R604.1, R605.1, U601.27 (AVDD); also elsewhere on the board
DRVR_ALARM: D601.2 (A), R604.2; also elsewhere on the board
DRVR_BRAKE: R602.1, U601.35 (BRAKE); also elsewhere on the board
DRVR_DIR: R603.1, U601.34 (DIR); also elsewhere on the board
DRVR_SPEED: U601.28 (SPEED/_WAKE); also elsewhere on the board
GND: C605.2, C606.2, C607.2, C609.2, NT601.2, R602.2, R603.2, U601.2 (DGND), U601.4 (GND_BK), U601.21 (DRVOFF), U601.26 (AGND), U601.41 (EXP); also elsewhere on the board
GNDPWR: C603.2, C604.2, C608.2, NT601.1, U601.12 (PGND), U601.15 (PGND), U601.18 (PGND); also elsewhere on the board
unnamed: R605.2, U601.29 (FG)
STM_I2C_SCL: U601.31 (SCL); also elsewhere on the board
STM_I2C_SDA: U601.30 (SDA); also elsewhere on the board
VM: C602.2, C603.1, C604.1, C608.1, JP601.1 (A), U601.9 (VM), U601.10 (VM), U601.11 (VM); also elsewhere on the board
VSYS: JP601.2 (B); also elsewhere on the board

Parts of its further copies:
C301, C501: 47n/25V; C_0402_1005Metric; Manufacturer Part Number GRT155R71E473KE01D
C302, C305, C306, C309, C502, C506, C507, C509: 1u/25V; C_0402_1005Metric; Manufacturer Part Number GRM155R61E105KA12J
C303, C503: 100n/16V; C_0402_1005Metric; Manufacturer Part Number CL05B104JO5NNNC
C304, C308, C504, C505: 10u/25V; C_1206_3216Metric; Manufacturer Part Number CL31B106KAHNFNE
C307, C508: 10u/10V; C_0402_1005Metric; Manufacturer Part Number GRM155R61A106ME11J
D301, D501: FAULT; LED_0603_1608Metric; Manufacturer Part Number SML-D12U1WT86
JP301, JP501: U301_EN; SolderJumper-2_P1.3mm_Open_RoundedPad1.0x1.5mm
L301, L501: 22u; L_1210_3225Metric; Manufacturer Part Number CBC3225T220MR
M301, M501: MOT; 15EDGVC-3-5-03P
NT301, NT501: NetTie_2; NetTie_2_0.4mm
R302, R303, R502, R503: 100k; R_0402_1005Metric; Manufacturer Part Number WR04X104 JTL
R304, R305, R504, R505: 5.1k; R_0402_1005Metric; Manufacturer Part Number RT0402FRE075K1L
U301, U501: MCT8315A1VRGFR; VQFN40_RGF_TEX_MCT8315A1VRGFR; Manufacturer Part Number MCT8315A1VRGFR

Connections of its further copies:
+3V3_BUCK: C307.1, C508.1, L301.2, L501.2, U301.3 (FB_BK), U501.3 (FB_BK); also elsewhere on the board
/MCU/BLDC Driver P/DRV_CP: C502.1, U501.8 (CP)
/MCU/BLDC Driver P/DRV_CPH: C501.1, U501.7 (CPH)
/MCU/BLDC Driver P/DRV_CPL: C501.2, U501.6 (CPL)
/MCU/BLDC Driver P/DRV_DVDD: C506.1, C507.1, U501.1 (DVDD)
/MCU/BLDC Driver P/DRV_FLED: D501.1 (K), U501.40 (~FAULT)
/MCU/BLDC Driver P/DRV_OUTA: M501.3 (A), U501.13 (OUT_A), U501.14 (OUT_A)
/MCU/BLDC Driver P/DRV_OUTB: M501.2 (B), U501.16 (OUT_B), U501.17 (OUT_B)
/MCU/BLDC Driver P/DRV_OUTC: M501.1 (C), U501.19 (OUT_C), U501.20 (OUT_C)
/MCU/BLDC Driver P/DRV_SW_BK: L501.1, U501.5 (SW_BK)
/MCU/BLDC Driver Y/DRV_CP: C302.1, U301.8 (CP)
/MCU/BLDC Driver Y/DRV_CPH: C301.1, U301.7 (CPH)
/MCU/BLDC Driver Y/DRV_CPL: C301.2, U301.6 (CPL)
/MCU/BLDC Driver Y/DRV_DVDD: C305.1, C306.1, U301.1 (DVDD)
/MCU/BLDC Driver Y/DRV_FLED: D301.1 (K), U301.40 (~FAULT)
/MCU/BLDC Driver Y/DRV_OUTA: M301.3 (A), U301.13 (OUT_A), U301.14 (OUT_A)
/MCU/BLDC Driver Y/DRV_OUTB: M301.2 (B), U301.16 (OUT_B), U301.17 (OUT_B)
/MCU/BLDC Driver Y/DRV_OUTC: M301.1 (C), U301.19 (OUT_C), U301.20 (OUT_C)
/MCU/BLDC Driver Y/DRV_SW_BK: L301.1, U301.5 (SW_BK)
AVDD: C309.1, C509.1, R304.1, R305.1, R504.1, R505.1, U301.27 (AVDD), U501.27 (AVDD); also elsewhere on the board
DRVP_ALARM: D501.2 (A), R504.2; also elsewhere on the board
DRVP_BRAKE: R502.1, U501.35 (BRAKE); also elsewhere on the board
DRVP_DIR: R503.1, U501.34 (DIR); also elsewhere on the board
DRVP_SPEED: U501.28 (SPEED/_WAKE); also elsewhere on the board
DRVY_ALARM: D301.2 (A), R304.2; also elsewhere on the board
DRVY_BRAKE: R302.1, U301.35 (BRAKE); also elsewhere on the board
DRVY_DIR: R303.1, U301.34 (DIR); also elsewhere on the board
DRVY_SPEED: U301.28 (SPEED/_WAKE); also elsewhere on the board
GND: C305.2, C306.2, C307.2, C309.2, C506.2, C507.2, C508.2, C509.2, NT301.2, NT501.2, R302.2, R303.2, R502.2, R503.2, U301.2 (DGND), U301.4 (GND_BK), U301.21 (DRVOFF), U301.26 (AGND), U301.41 (EXP), U501.2 (DGND), U501.4 (GND_BK), U501.21 (DRVOFF), U501.26 (AGND), U501.41 (EXP); also elsewhere on the board
GNDPWR: C303.2, C304.2, C308.2, C503.2, C504.2, C505.2, NT301.1, NT501.1, U301.12 (PGND), U301.15 (PGND), U301.18 (PGND), U501.12 (PGND), U501.15 (PGND), U501.18 (PGND); also elsewhere on the board
unnamed: R305.2, U301.29 (FG)
unnamed: R505.2, U501.29 (FG)
STM_I2C_SCL: U301.31 (SCL), U501.31 (SCL); also elsewhere on the board
STM_I2C_SDA: U301.30 (SDA), U501.30 (SDA); also elsewhere on the board
VM: C302.2, C303.1, C304.1, C308.1, C502.2, C503.1, C504.1, C505.1, JP301.1 (A), JP501.1 (A), U301.9 (VM), U301.10 (VM), U301.11 (VM), U501.9 (VM), U501.10 (VM), U501.11 (VM); also elsewhere on the board
VSYS: JP301.2 (B), JP501.2 (B); also elsewhere on the board

Notes on the sheet:
EXT_CLK_EN = 0h
EXT_WD_EN = 0h

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
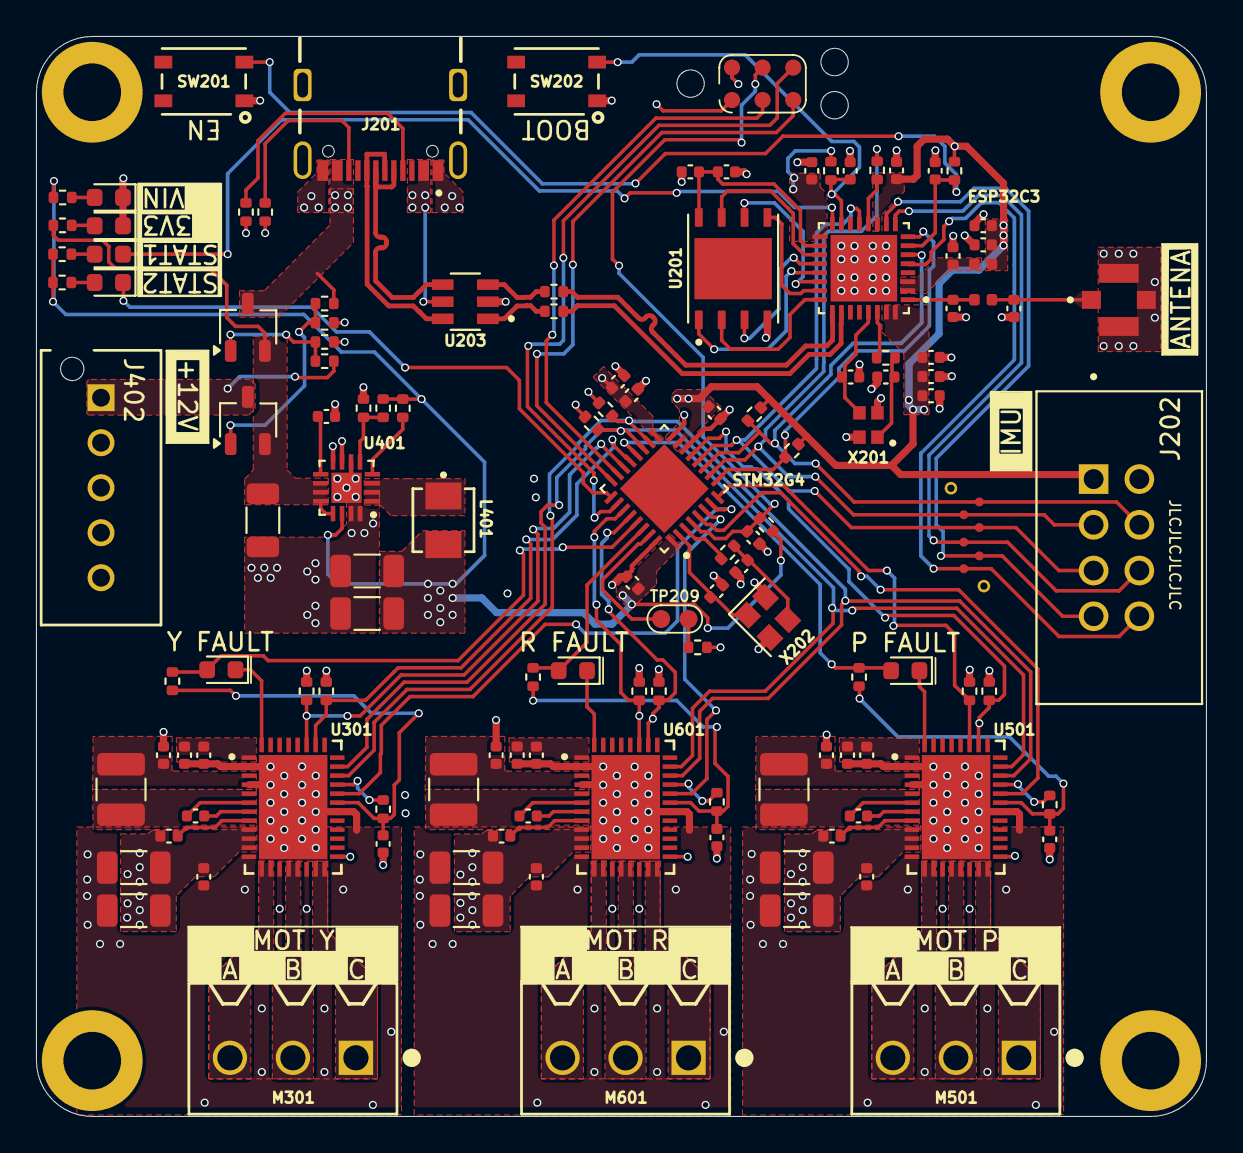
[picture p17: board SynchGaze_Motor_Control.kicad_pcb from above]

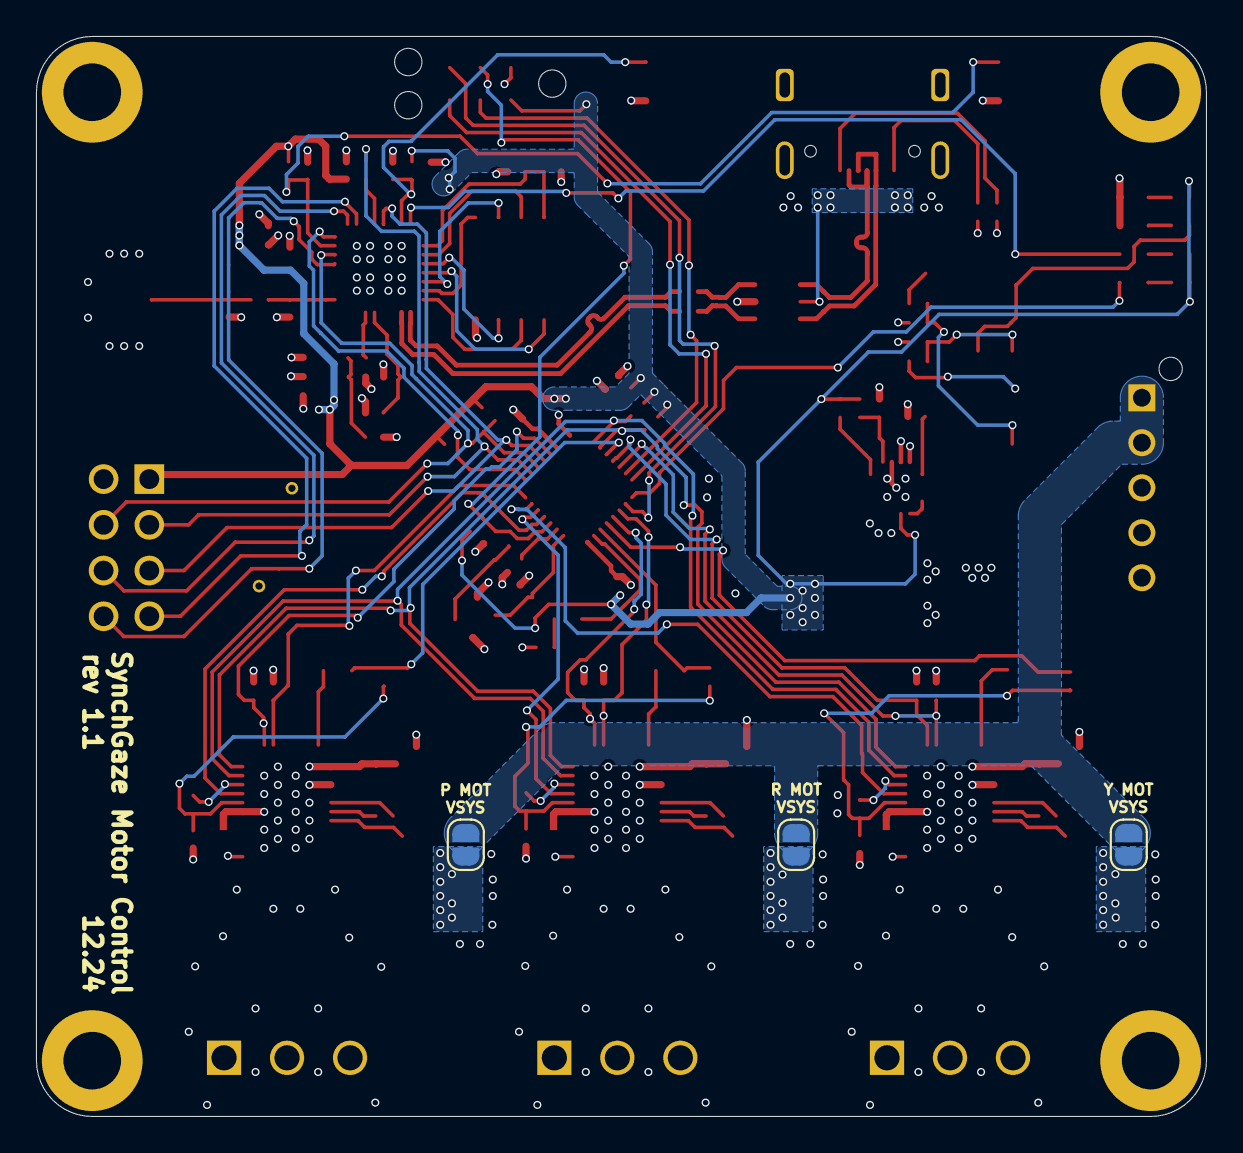
[picture p18: board SynchGaze_Motor_Control.kicad_pcb from below]

Board: 4 copper layers, 65.0 x 60.0 mm, 142 parts (3 on the bottom side), 105 nets.
