WojciechM98/SynchGaze/SynchGaze_Transmiter/SynchGaze_Transmiter.kicad_pcb

## KiCad design SynchGaze_Transmiter/SynchGaze_Transmiter.kicad_pcb (2025-01-06)

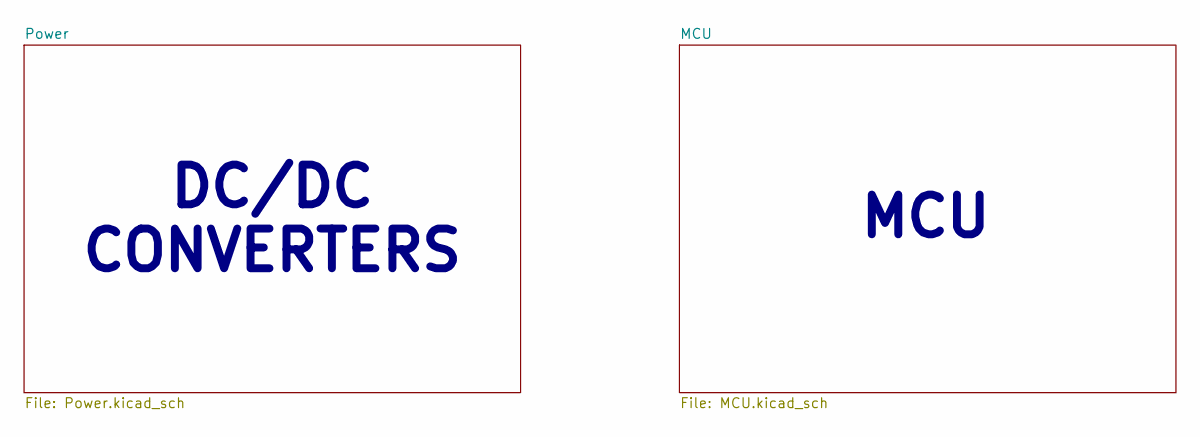
[picture p19: schematic SynchGaze_Transmiter.kicad_sch, SynchGaze - Transmiter]

Notes on the sheet:
MCU
DC/DC CONVERTERS

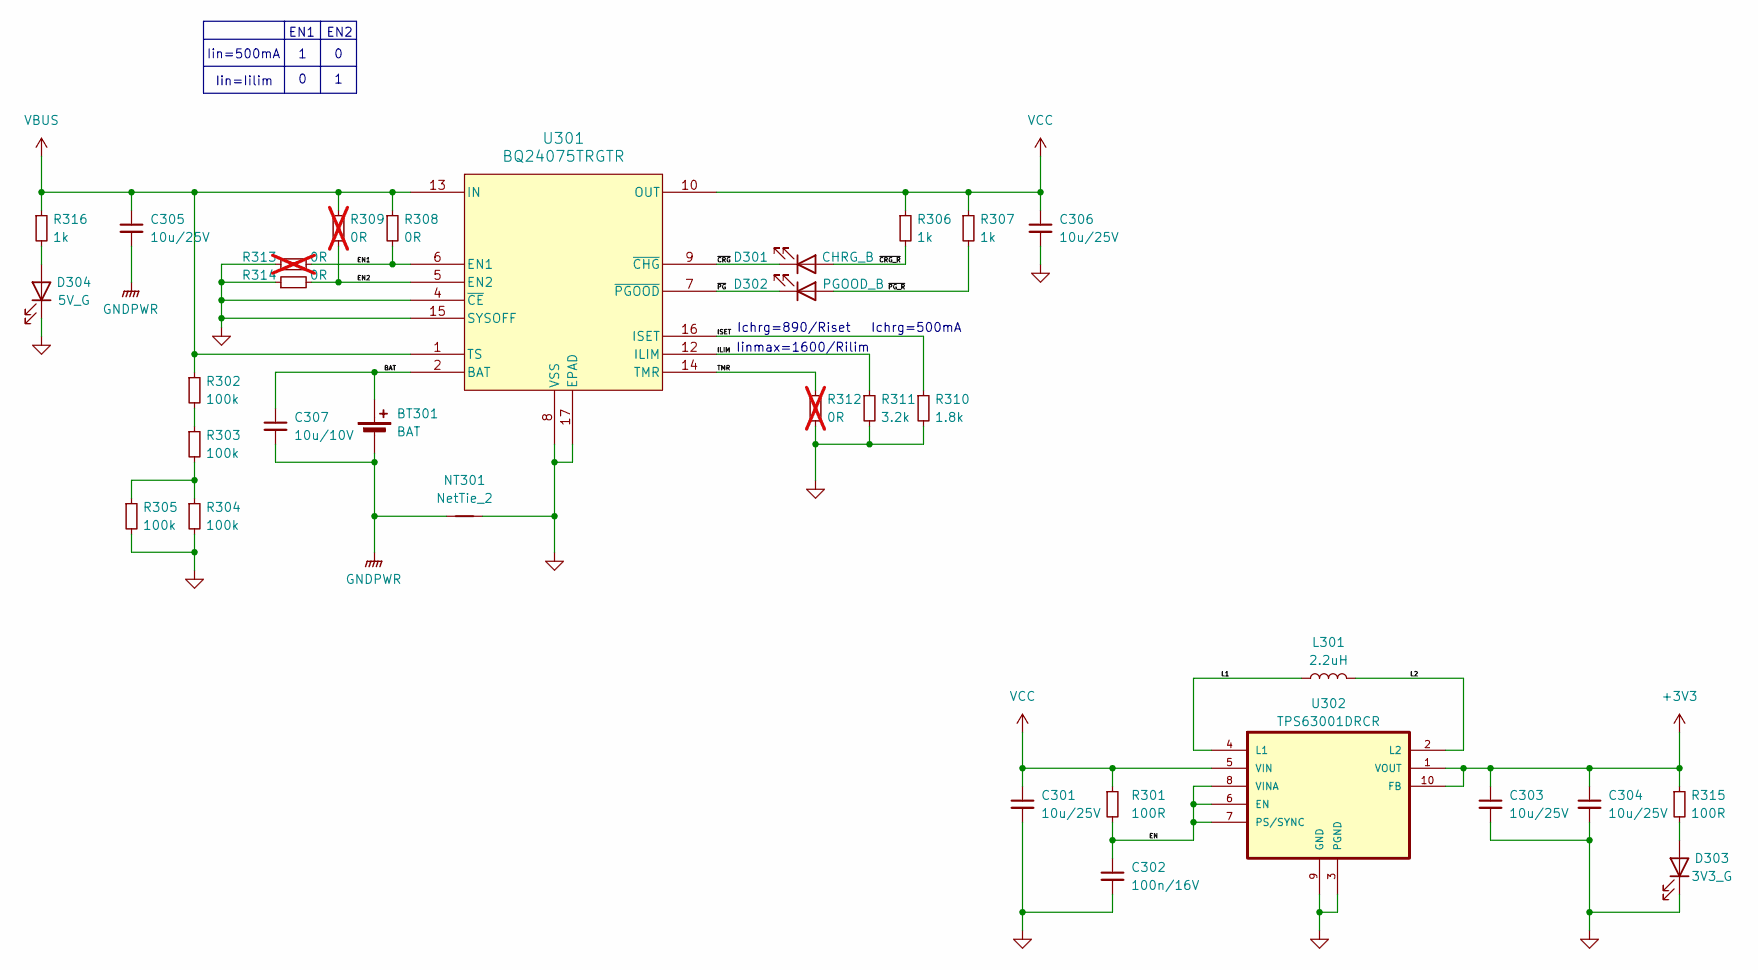
[picture p20: schematic Power.kicad_sch, SynchGaze - Transmiter]

Parts:
BT301: BAT; SM02B-SRSS-TB_LF__SN_; Manufacturer Part Number ACCU-LP542439/CL
C301, C303, C304, C305, C306: 10u/25V; C_1206_3216Metric; Manufacturer Part Number CL31B106KAHNFNE
C302: 100n/16V; C_0402_1005Metric; Manufacturer Part Number CL05B104JO5NNNC
C307: 10u/10V; C_0402_1005Metric; Manufacturer Part Number GRM155R61A106ME11J
D301: CHRG_B; LED_0603_1608Metric; Manufacturer Part Number 150060BS55040
D302: PGOOD_B; LED_0603_1608Metric; Manufacturer Part Number 150060BS55040
D303: 3V3_G; LED_0603_1608Metric; Manufacturer Part Number 150060GS55040
D304: 5V_G; LED_0603_1608Metric; Manufacturer Part Number 150060GS55040
L301: 2.2uH; L_Abracon_ASPI-3012S; Manufacturer Part Number NRH3012T2R2MNV
NT301: NetTie_2; NetTie-2_SMD_0.4mm
R301, R315: 100R; R_0402_1005Metric; Manufacturer Part Number RC0402JR-07100RP
R302, R303, R304, R305: 100k; R_0402_1005Metric; Manufacturer Part Number WR04X104 JTL
R306, R307, R316: 1k; R_0402_1005Metric; Manufacturer Part Number RT0402FRE071KL
R308, R314: 0R; R_0402_1005Metric; Manufacturer Part Number RC0402JR-070RP
R309, R312, R313: 0R; R_0402_1005Metric; Manufacturer Part Number RC0402JR-070RP; not fitted
R310: 1.8k; R_0402_1005Metric; Manufacturer Part Number RT0402FRE071K8L
R311: 3.2k; R_0402_1005Metric; Manufacturer Part Number RT0402DRE073K2L
U301: BQ24075TRGTR; Manufacturer Part Number BQ24075TRGTR
U302: TPS63001DRCR; VREG_V62_16624-01YE_TPS63001DRCR; Manufacturer Part Number TPS63001DRCR

Connections:
+3V3: C303.1, C304.1, R315.1, U302.1 (VOUT), U302.10 (FB); also elsewhere on the board
/Power/BAT: BT301.1 (+), C307.1, U301.2 (BAT), U301.3 (BAT)
/Power/EN: C302.1, R301.2, U302.6 (EN), U302.7 (PS/SYNC), U302.8 (VINA)
/Power/EN1: R308.2, R313.2, U301.6 (EN1)
/Power/EN2: R309.2, R314.2, U301.5 (EN2)
/Power/ILIM: R311.1, U301.12 (ILIM)
/Power/ISET: R310.1, U301.16 (ISET)
/Power/L1: L301.1, U302.4 (L1)
/Power/L2: L301.2, U302.2 (L2)
/Power/TMR: R312.1, U301.14 (TMR)
/Power/~CRG_R: D301.2 (A), R306.2
/Power/~CRG: D301.1 (K), U301.9 (~CHG)
/Power/~PG_R: D302.2 (A), R307.2
/Power/~PG: D302.1 (K), U301.7 (~PGOOD)
GND: C301.2, C302.2, C303.2, C304.2, C306.2, D303.1 (K), D304.1 (K), NT301.2, R304.2, R305.2, R310.2, R311.2, R312.2, R313.1, R314.1, U301.4 (~CE), U301.8 (VSS), U301.15 (SYSOFF), U301.17 (EPAD), U302.3 (PGND), U302.9 (GND), U302.11 (POWER_PAD); also elsewhere on the board
GNDPWR: BT301.2 (-), C305.2, C307.2, NT301.1
unnamed: D303.2 (A), R315.2
unnamed: D304.2 (A), R316.2
unnamed: R302.2, R303.1
unnamed: R303.2, R304.1, R305.1
VBUS: C305.1, R302.1, R308.1, R309.1, R316.1, U301.1 (TS), U301.13 (IN); also elsewhere on the board
VCC: C301.1, C306.1, R301.1, R306.1, R307.1, U301.10 (OUT), U301.11 (OUT), U302.5 (VIN)

Notes on the sheet:
Iin=500mA
EN1
EN2
Iin=Iilim
Iinmax=1600/Rilim
Ichrg=500mA
Ichrg=890/Riset
