WojciechM98/SynchGaze/SynchGaze_Transmiter/SynchGaze_Transmiter.kicad_pcb

## KiCad design SynchGaze_Transmiter/SynchGaze_Transmiter.kicad_pcb (continued)

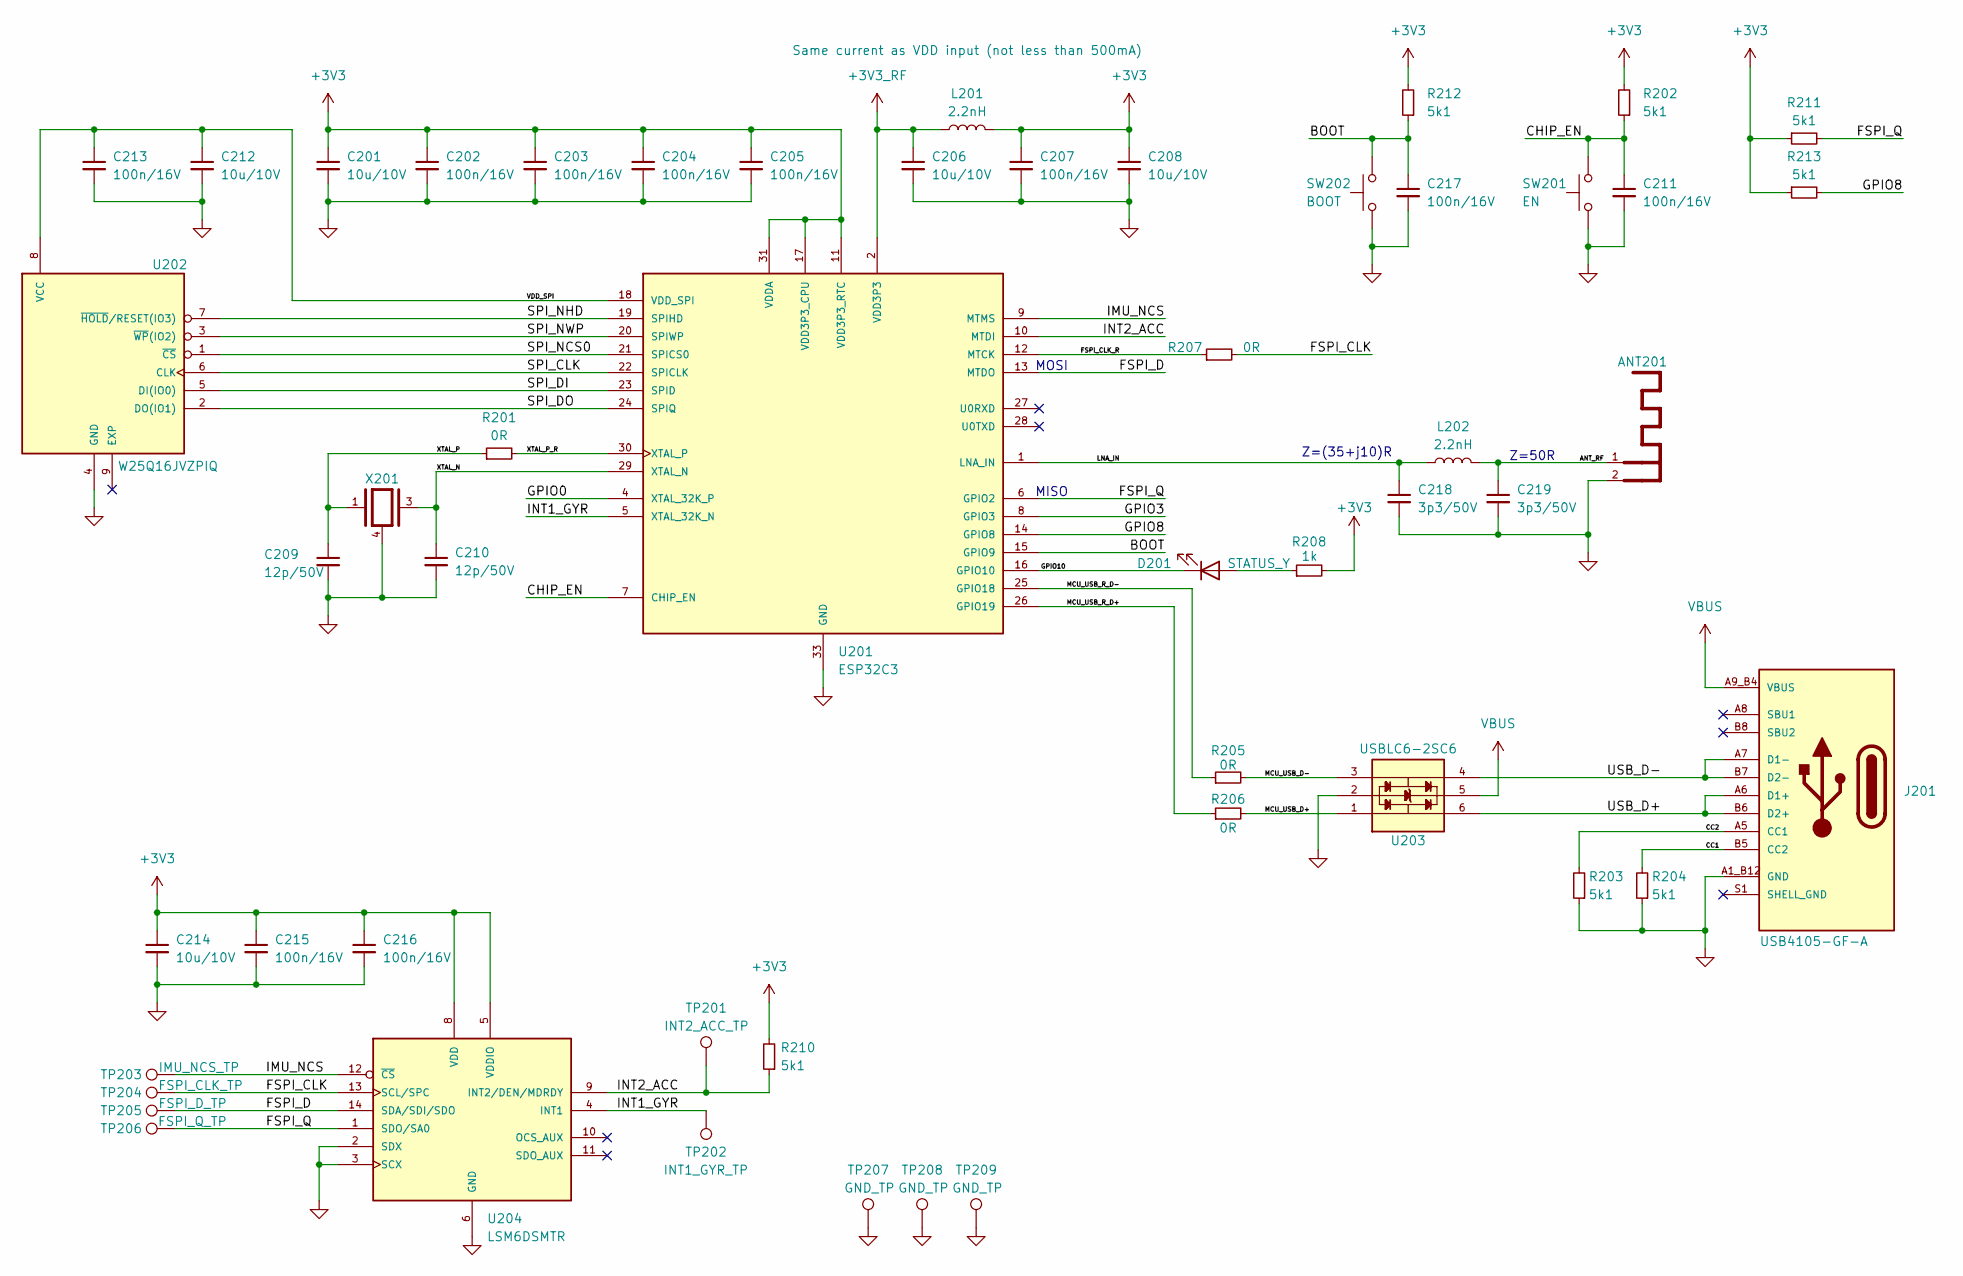
[picture p21: schematic MCU.kicad_sch, SynchGaze - Transmiter]

Parts:
ANT201: Ant_2_4ghz_50ohm
C201, C206, C208, C212, C214: 10u/10V; C_0402_1005Metric; Manufacturer Part Number GRM155R61A106ME11J
C202, C203, C204, C205, C207, C211, C213, C215, C216, C217: 100n/16V; C_0402_1005Metric; Manufacturer Part Number CL05B104JO5NNNC
C209, C210: 12p/50V; C_0402_1005Metric; Manufacturer Part Number GRM1555C1H120JA01D
C218, C219: 3p3/50V; C_0402_1005Metric; Manufacturer Part Number 0402N3R3D500CT
D201: STATUS_Y; LED_0603_1608Metric; Manufacturer Part Number 150060YS55040
J201: USB4105-GF-A; GCT_USB4105-GF-A; PARTREV 3
L201, L202: 2.2nH; L_0402_1005Metric; Manufacturer Part Number LQG15HN2N2S02D
R201, R205, R206, R207: 0R; R_0402_1005Metric; Manufacturer Part Number RC0402JR-070RP
R202, R203, R204, R210, R211, R212, R213: 5k1; R_0402_1005Metric; Manufacturer Part Number RT0402FRE075K1L
R208: 1k; R_0402_1005Metric; Manufacturer Part Number RT0402FRE071KL
SW201: EN; SW4_PTS815 SJM 250 SMTR LFS_CNK; Manufacturer Part Number RKB2SJM250SMTR LFS
SW202: BOOT; SW4_PTS815 SJM 250 SMTR LFS_CNK; Manufacturer Part Number RKB2SJM250SMTR LFS
TP201: INT2_ACC_TP; test_point_SMD_0.5mm
TP202: INT1_GYR_TP; test_point_SMD_0.5mm
TP203: IMU_NCS_TP; test_point_SMD_0.5mm
TP204: FSPI_CLK_TP; test_point_SMD_0.5mm
TP205: FSPI_D_TP; test_point_SMD_0.5mm
TP206: FSPI_Q_TP; test_point_SMD_0.5mm
TP207, TP208, TP209: GND_TP; test_point_THT 0.7mm
U201: ESP32C3; QFN32_5X5MM_ESP32C3; Manufacturer Part Number ESP32-C3
U202: W25Q16JVZPIQ; SON127P500X600X80-9N; Manufacturer Part Number W25Q16JVZPIQ
U203: USBLC6-2SC6; SOT95P280X145-6N; Manufacturer Part Number USBLC6-2SC6
U204: LSM6DSMTR; PQFN50P300X250X86-14N_LSM6DSMTR; PARTREV Rev 7
X201: XRCGB40M000F4M02R0; OSC_XRCGB40M000F4M02R0; PARTREV N/A

Connections:
+3V3: C201.1, C202.1, C203.1, C204.1, C205.1, C207.1, C208.1, C214.1, C215.1, C216.1, L201.2, R202.2, R208.2, R210.2, R211.1, R212.2, R213.1, U201.11 (VDD3P3_RTC), U201.17 (VDD3P3_CPU), U201.31 (VDDA), U201.32 (VDDA), U204.5 (VDDIO), U204.8 (VDD); also elsewhere on the board
+3V3_RF: C206.1, L201.1, U201.2 (VDD3P3), U201.3 (VDD3P3)
/MCU/ANT_RF: ANT201.1, C219.1, L202.2
/MCU/BOOT: C217.1, R212.1, SW202.2, U201.15 (GPIO9)
/MCU/CC1: J201.B5 (CC2), R204.2
/MCU/CC2: J201.A5 (CC1), R203.2
/MCU/CHIP_EN: C211.1, R202.1, SW201.2, U201.7 (CHIP_EN)
/MCU/FSPI_CLK: R207.2, TP204.1, U204.13 (SCL/SPC)
/MCU/FSPI_CLK_R: R207.1, U201.12 (MTCK)
/MCU/FSPI_D: TP205.1, U201.13 (MTDO), U204.14 (SDA/SDI/SDO)
/MCU/FSPI_Q: R211.2, TP206.1, U201.6 (GPIO2), U204.1 (SDO/SA0)
/MCU/GPIO0: U201.4 (XTAL_32K_P)
/MCU/GPIO3: U201.8 (GPIO3)
/MCU/GPIO8: R213.2, U201.14 (GPIO8)
/MCU/GPIO10: D201.1 (K), U201.16 (GPIO10)
/MCU/IMU_NCS: TP203.1, U201.9 (MTMS), U204.12 (~CS)
/MCU/INT1_GYR: TP202.1, U201.5 (XTAL_32K_N), U204.4 (INT1)
/MCU/INT2_ACC: R210.1, TP201.1, U201.10 (MTDI), U204.9 (INT2/DEN/MDRDY)
/MCU/LNA_IN: C218.1, L202.1, U201.1 (LNA_IN)
/MCU/MCU_USB_D+: R206.2, U203.1
/MCU/MCU_USB_D-: R205.2, U203.3
/MCU/MCU_USB_R_D+: R206.1, U201.26 (GPIO19)
/MCU/MCU_USB_R_D-: R205.1, U201.25 (GPIO18)
/MCU/SPI_CLK: U201.22 (SPICLK), U202.6 (CLK)
/MCU/SPI_DI: U201.23 (SPID), U202.5 (DI(IO0))
/MCU/SPI_DO: U201.24 (SPIQ), U202.2 (DO(IO1))
/MCU/SPI_NCS0: U201.21 (SPICS0), U202.1 (~CS)
/MCU/SPI_NHD: U201.19 (SPIHD), U202.7 (~HOLD/RESET(IO3))
/MCU/SPI_NWP: U201.20 (SPIWP), U202.3 (~WP(IO2))
/MCU/USB_D+: J201.A6 (D1+), J201.B6 (D2+), U203.6
/MCU/USB_D-: J201.A7 (D1-), J201.B7 (D2-), U203.4
/MCU/VDD_SPI: C212.1, C213.1, U201.18 (VDD_SPI), U202.8 (VCC)
/MCU/XTAL_N: C210.1, U201.29 (XTAL_N), X201.3
/MCU/XTAL_P: C209.1, R201.1, X201.1
/MCU/XTAL_P_R: R201.2, U201.30 (XTAL_P)
GND: ANT201.2, C201.2, C202.2, C203.2, C204.2, C205.2, C206.2, C207.2, C208.2, C209.2, C210.2, C211.2, C212.2, C213.2, C214.2, C215.2, C216.2, C217.2, C218.2, C219.2, J201.A1_B12 (GND), J201.A12_B1 (GND), R203.1, R204.1, SW201.1, SW202.1, TP207.1, TP208.1, TP209.1, U201.33 (GND), U202.4 (GND), U203.2, U204.2 (SDX), U204.3 (SCX), U204.6 (GND), U204.7 (GND), X201.2, X201.4; also elsewhere on the board
unnamed: D201.2 (A), R208.1
VBUS: J201.A4_B9 (VBUS), J201.A9_B4 (VBUS), U203.5; also elsewhere on the board

Notes on the sheet:
Z=50R
Z=(35+j10)R
MOSI
MISO

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
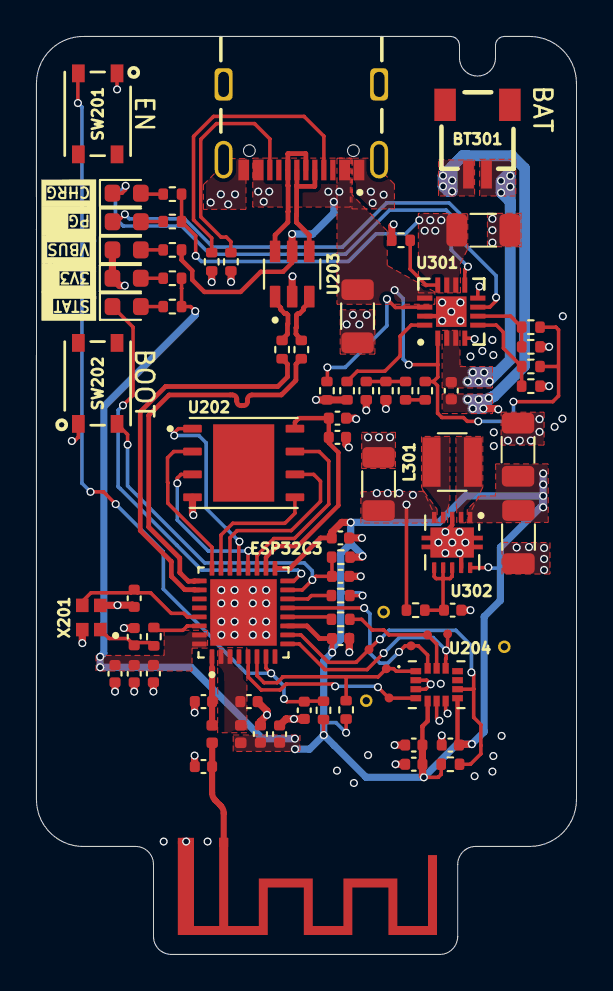
[picture p22: board SynchGaze_Transmiter.kicad_pcb from above]

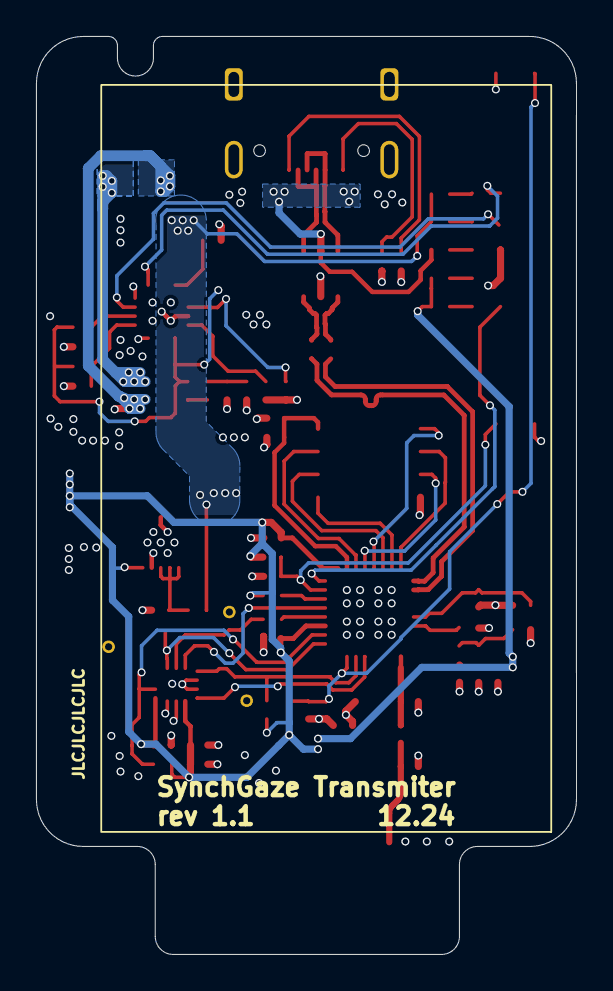
[picture p23: board SynchGaze_Transmiter.kicad_pcb from below]

Board: 4 copper layers, 30.0 x 51.0 mm, 85 parts (2 on the bottom side), 55 nets.

Other parts of the board:
ACCU-LP542439/CL: LP542439
