WojciechM98/SynchGaze/(commit log)

2024-09-21 First develop version rev 1.0
    [BLDC_Driver.kicad_sch, MCU.kicad_sch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]
2025-01-06 rev 1.1
    [BLDC_Driver.kicad_sch, MCU.kicad_sch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]
2025-01-06 Small changes
    [SynchGaze_Motor_Control.kicad_pcb, SynchGaze_Transmiter.kicad_pcb]
2025-01-06 Changed screenshots names to match PCB revision
